jeffmakes/tr23-badge-hw/r2/build/tr23-r2-bom/img/20230305_191125.jpg

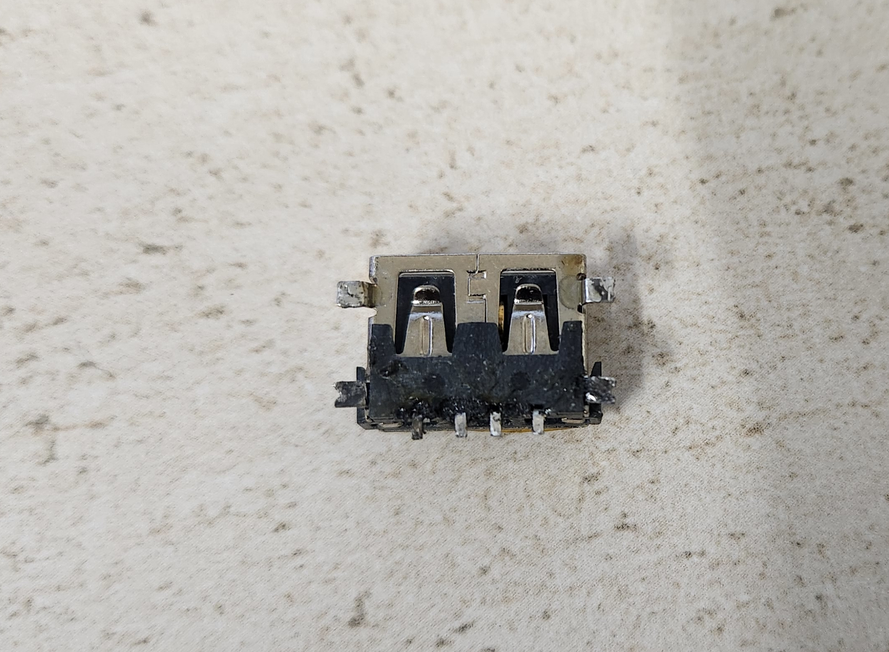
r2/build/tr23-r2-bom/img/20230305_191125.jpg
