jeffmakes/tr23-badge-hw/design/board-graphics/tr23-identity-r1-crop.png

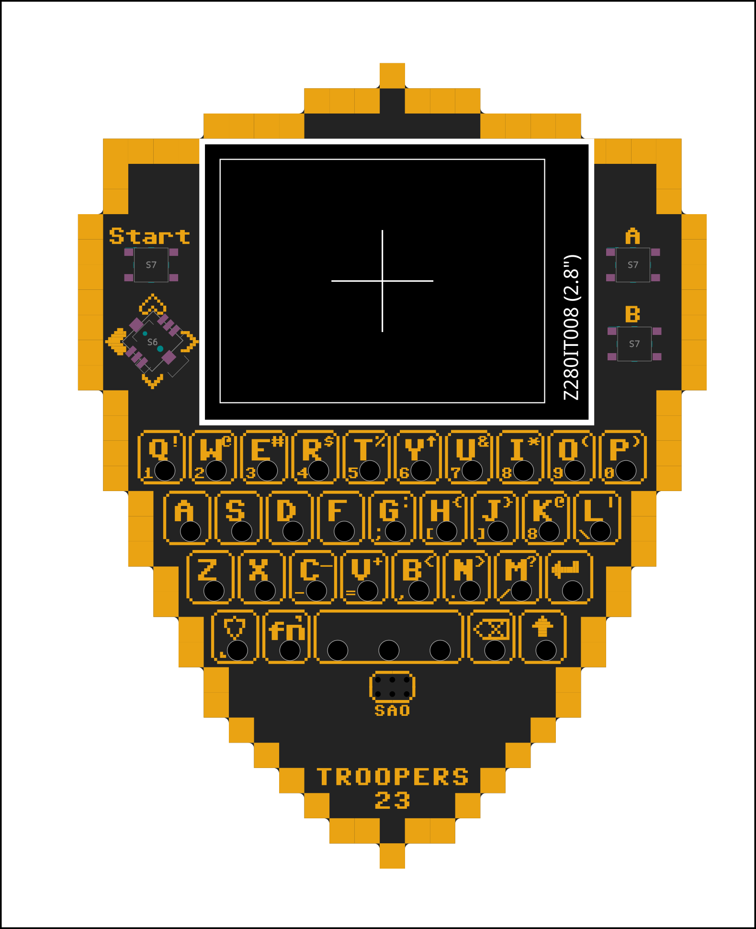
design/board-graphics/tr23-identity-r1-crop.png
