jeffmakes/tr23-badge-hw/design/board-graphics/tr23-identity-r1.png

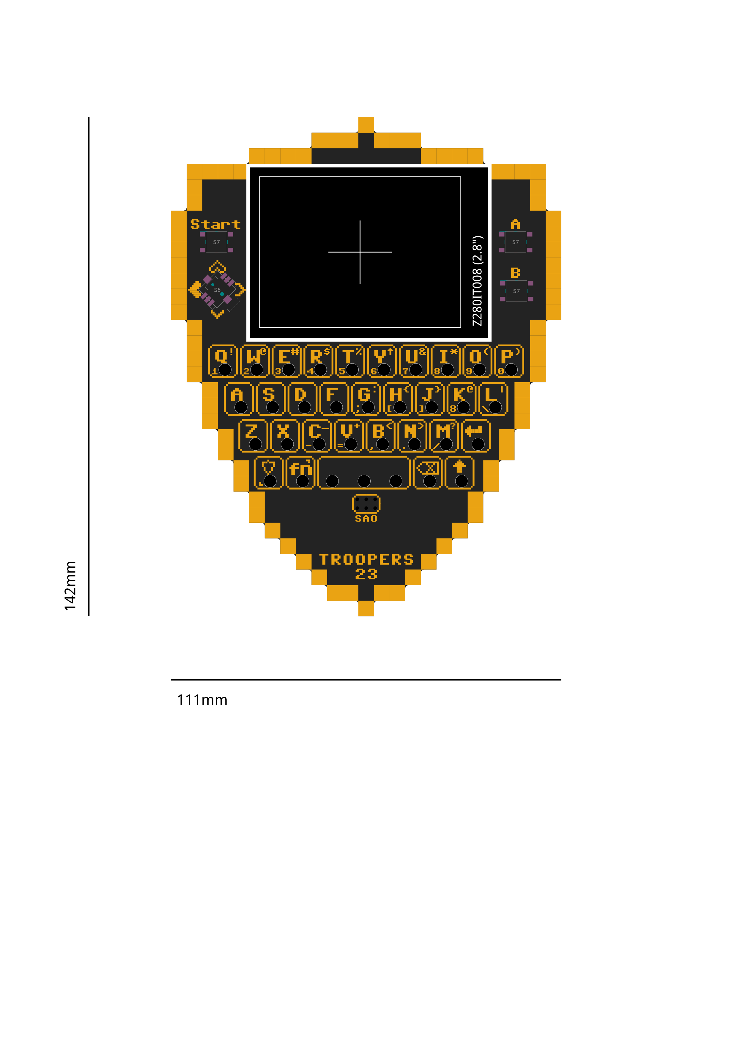
design/board-graphics/tr23-identity-r1.png
