jeffmakes/tr23-badge-hw/r2/build/tr23-r2-bom/img/20230108_FUET-FS1511P01-H40_C482343_back.jpg

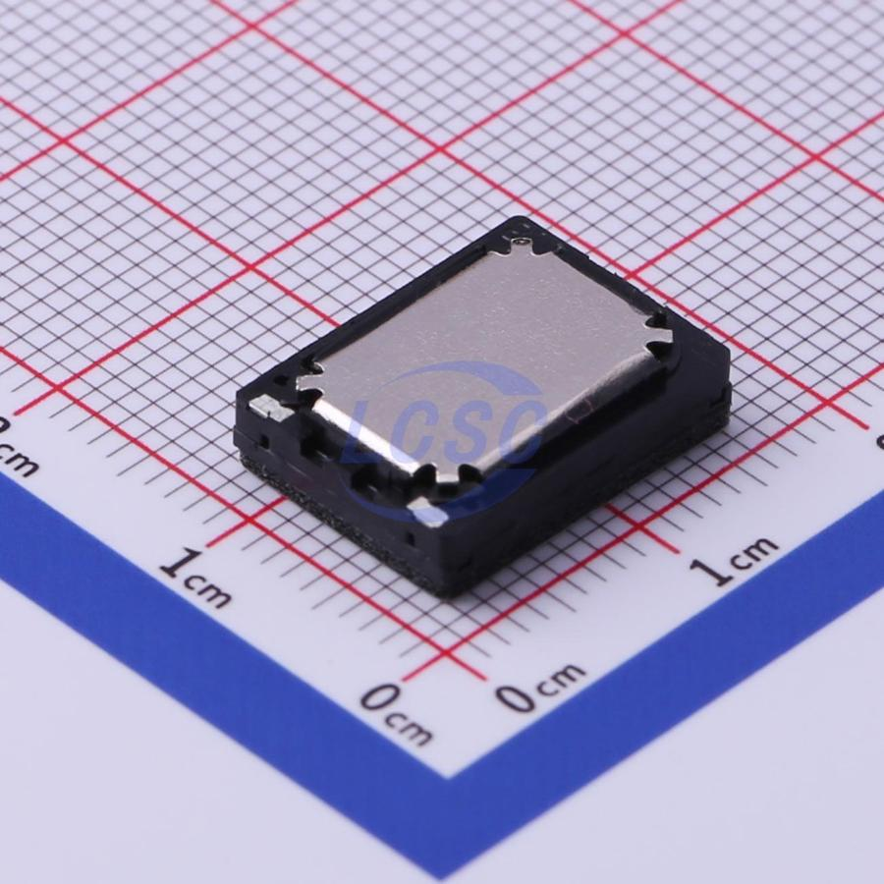
r2/build/tr23-r2-bom/img/20230108_FUET-FS1511P01-H40_C482343_back.jpg
