jeffmakes/tr23-badge-hw/r2/build/tr23-r2-bom/img/colour-switches.png

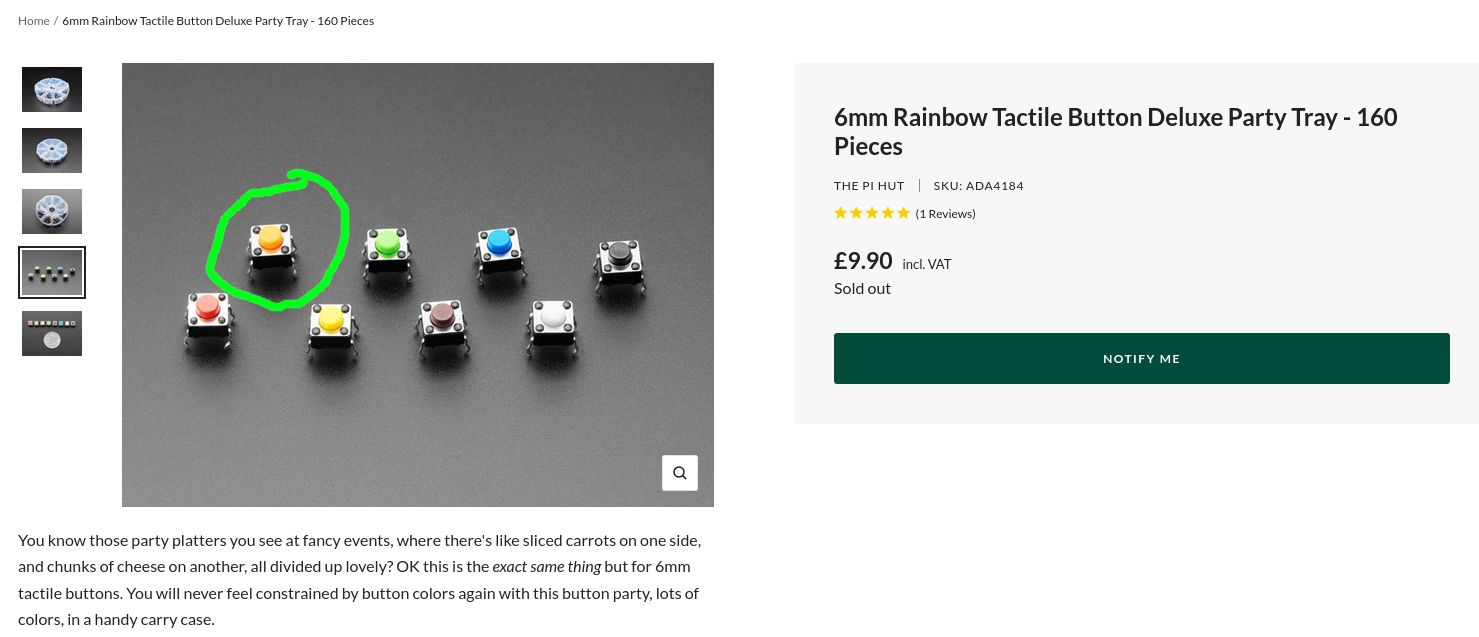
r2/build/tr23-r2-bom/img/colour-switches.png
