jeffmakes/tr23-badge-hw/r2/build/tr23-r2-bom/img/rev-mount-sw-datasheet1.png

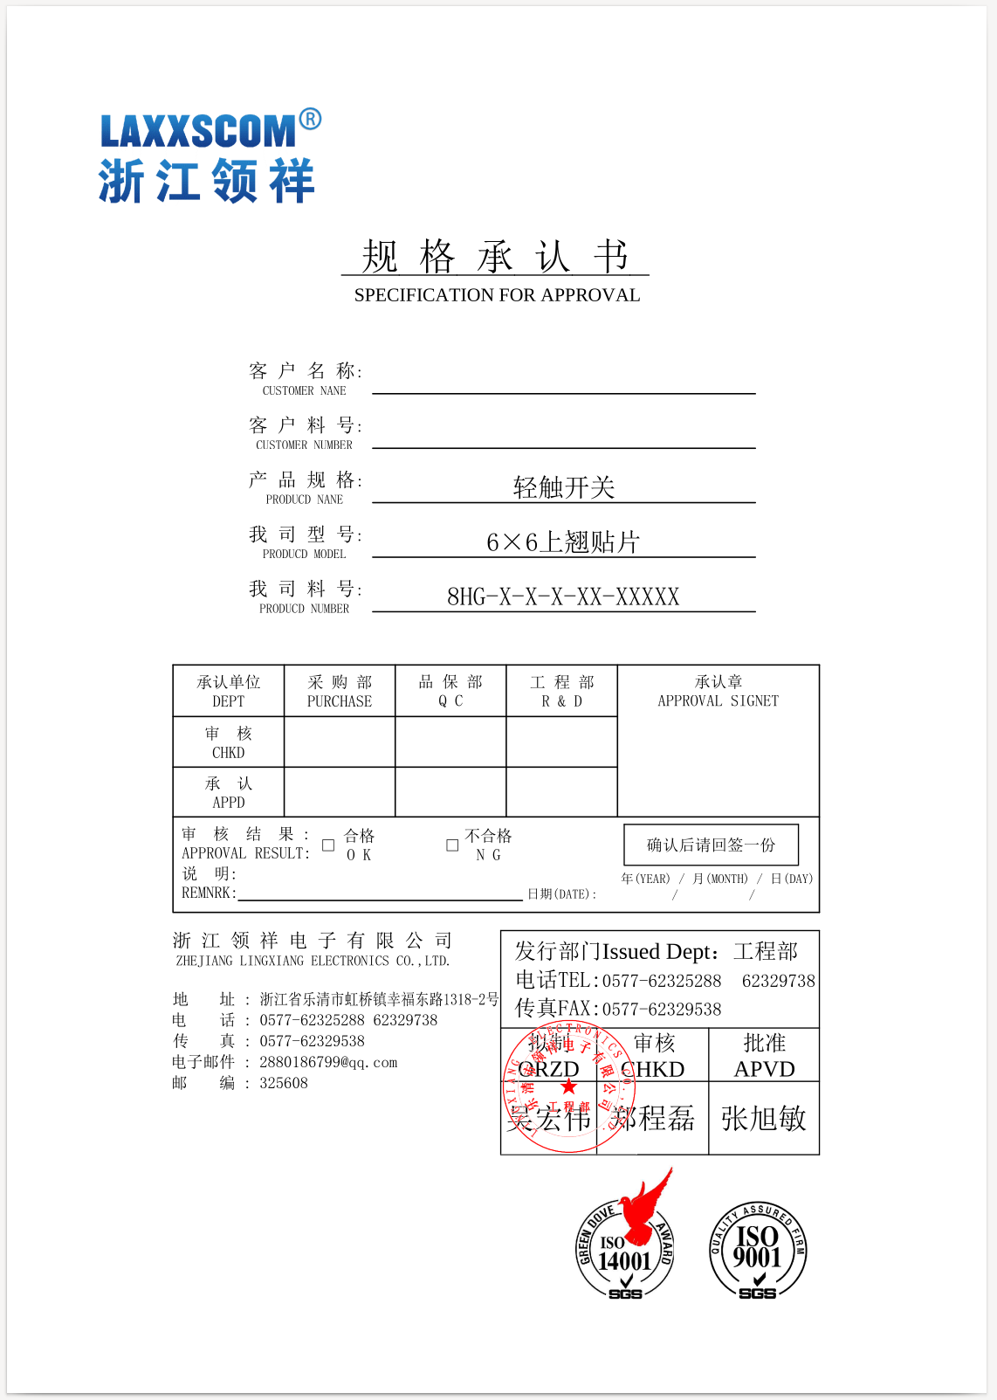
r2/build/tr23-r2-bom/img/rev-mount-sw-datasheet1.png
