jeffmakes/tr23-badge-hw/r2/build/tr23-r2-bom/img/reverse-mount-switch.jpg

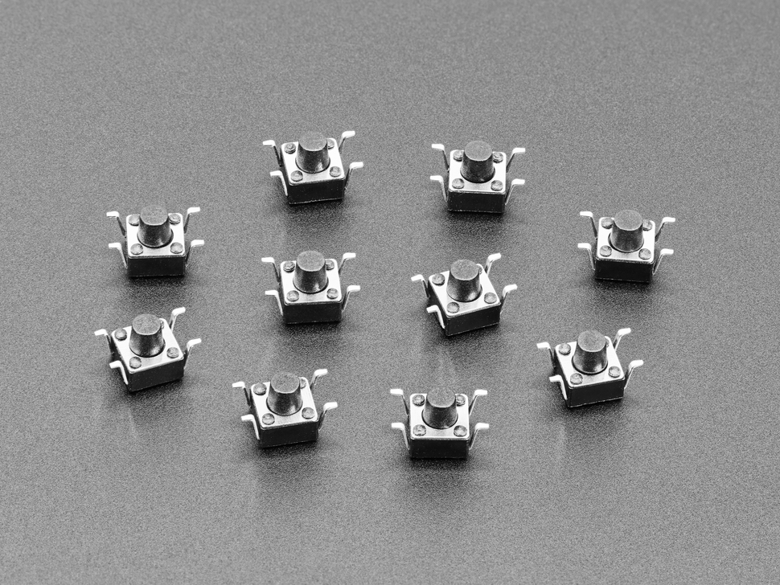
r2/build/tr23-r2-bom/img/reverse-mount-switch.jpg
