jeffmakes/tr23-badge-hw/r2/build/README.txt

PCB spec:

4-layer
Thickness: 1.2mm
Material: FR4

Silkscreen: Orange LPI top and bottom. 
Resist: Black matte finish top and bottom
Vias tented
Plating - Any

Gerber stack-up:
F.Cu 35um
In1.Cu 17um
In2.Cu 17um
B.Cu 35um
