jeffmakes/tr23-badge-hw/tr23-outline-test-r1/build/README.txt

Stackup:
Total thickness 1.6mm

Outline profile: routed all around. Max cutter diameter 2mm. Smaller preferred if reasonable.

Silk - white LPI - front side only
Resist - black (matte preferred if available as standard). Please also quote for ordinary green.
Plating: any
No PTH's in design.
