jeffmakes/tr23-badge-hw/r2/test/test.ods

Test | Status | Notes
Display | OK
Joystick, buttons | OK
Audio, incl power amp, uSD | OK
Charging | OK
Charging from type-C to type-C cable | OK
Run from battery | OK
Haptic | OK
LED’s | OK | Replaced with LTST-E683CEGBK, which is LiteON’s version of WS2812-3535
Touch; I2C ping will suffice | OK | Still need bootloader client, and test with coverlay
Radio; SPI ping will suffice | OK
Touch surface | OK
