jeffmakes/tr23-badge-hw/tr23-outline-test-r1/build/tr23-outline-test-r1.png

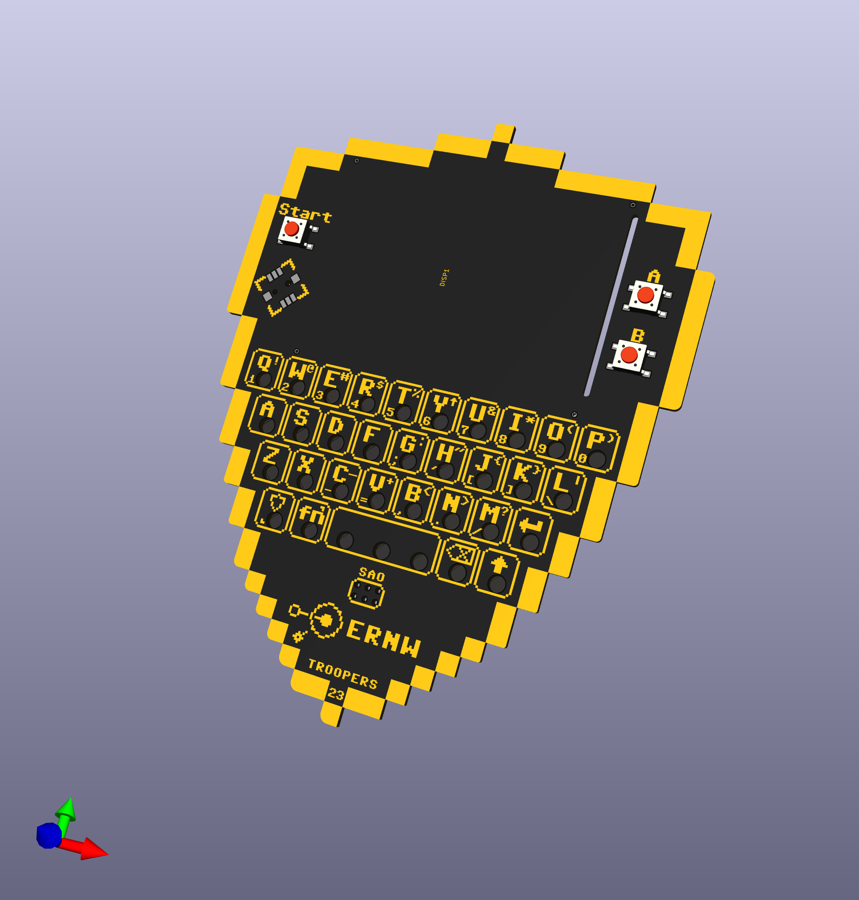
tr23-outline-test-r1/build/tr23-outline-test-r1.png
