jeffmakes/tr23-badge-hw/r2/build/tr23-r2-plots/tr23-badge-r2.pdf

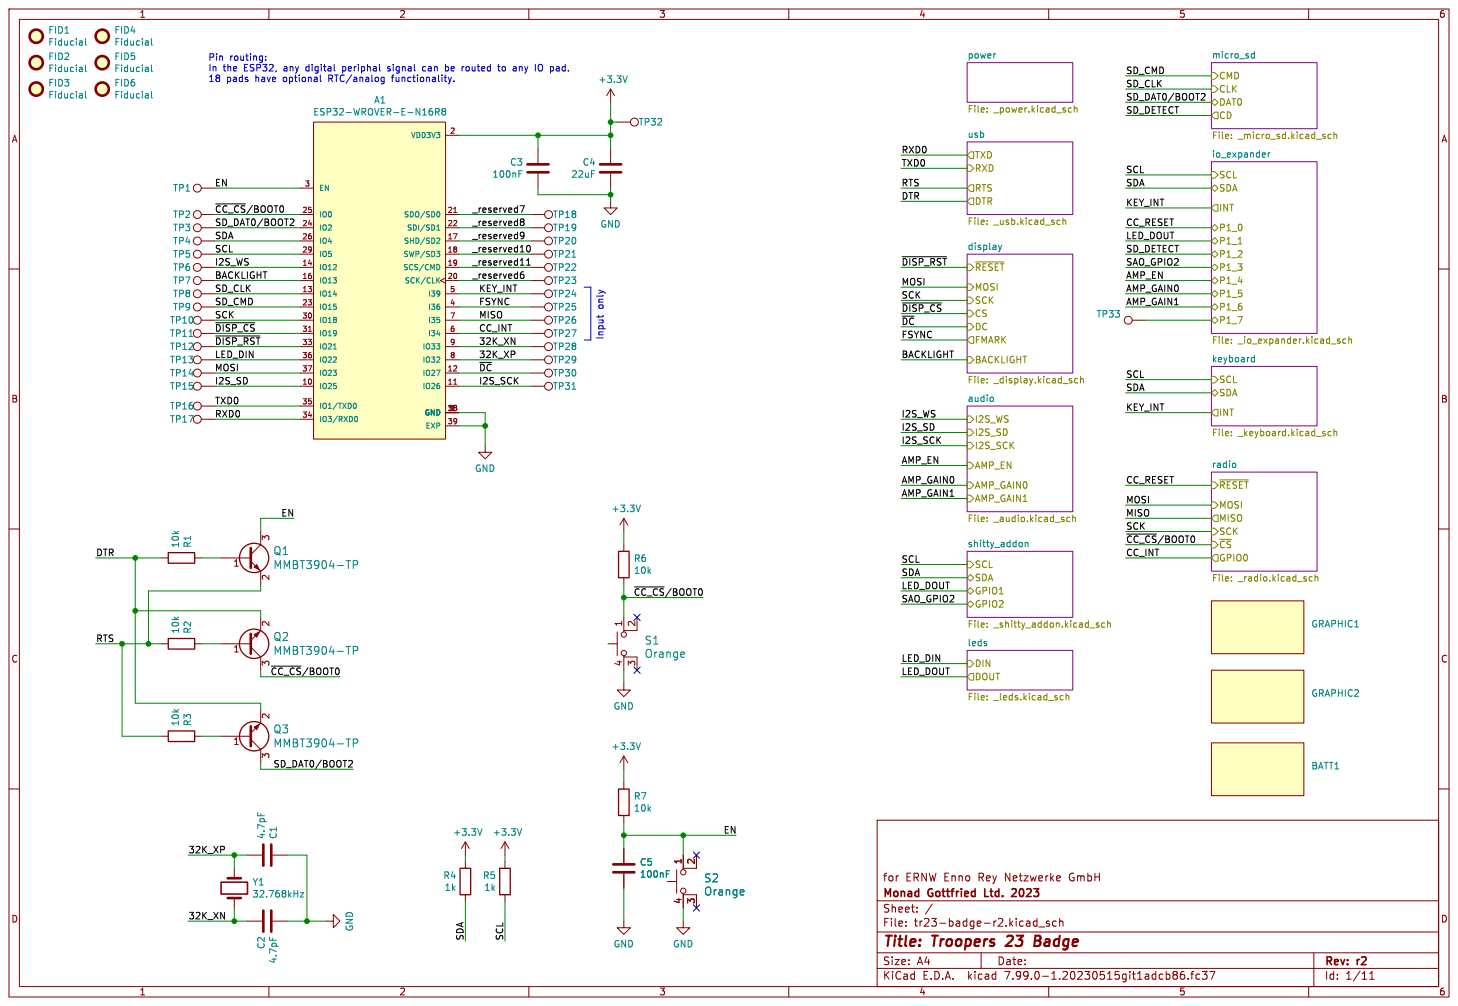
[picture p18: page 1]

power File: _power.kicad_sch RTS RXD

CLK DAT0 CD micro_sd File: _micro_sd.kicad_sch BACKLIGHT CSDC
io_expander File: _io_expander.kicad_sch MOSI MISO
display File: _display.kicad_sch DIN

Id: 1/11 Title: Troopers 23 Badge

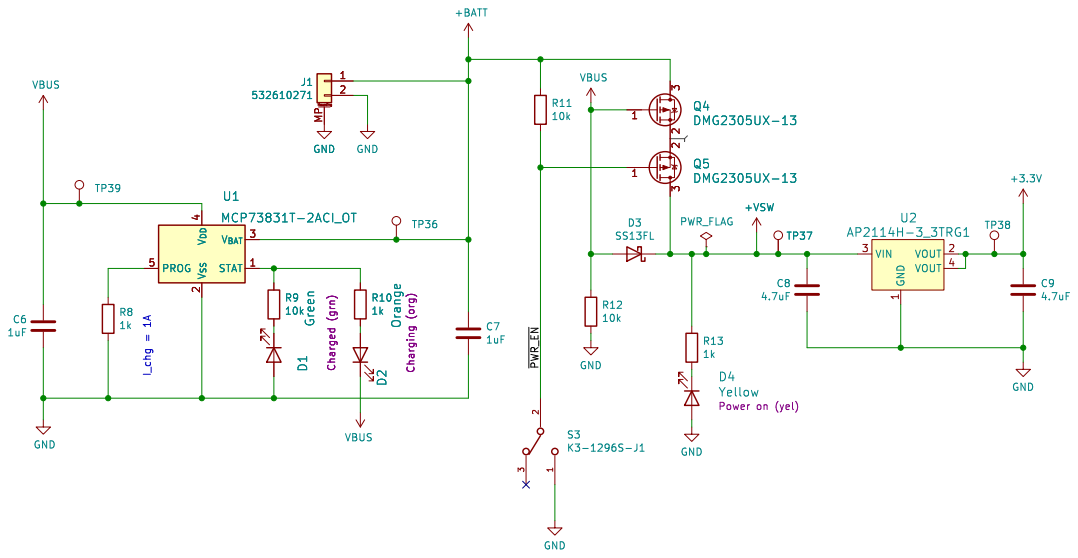
[picture p19: page 2]

Id: 2/11 Title: Troopers 23 Badge

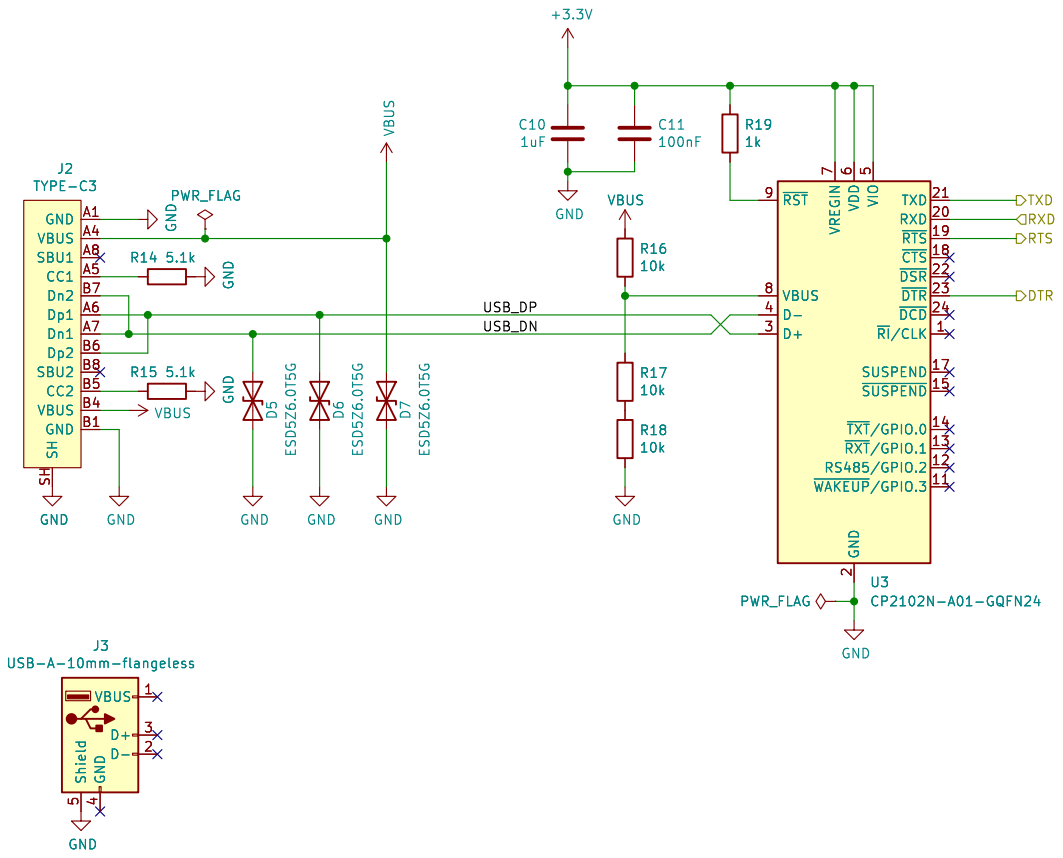
[picture p20: page 3]

7 VBUS 8 ~{RST} 9 U3 PWR_FLAG CP2102N-A01-GQFN24 GND A1 VBUS A4 CC1 A5 Dp1 A6 Dn1 A7 SBU1 A8 GND B1 VBUS B4 CC2 B5 Dp2 B6 Dn2 B7 SBU2 B8 SH SH J2 TYPE-C3 GND

2 RXD 20 TXD 21 ~{DSR} 22 ~{DTR} 23 ~{DCD} 24 D+ 3 D- 4 VIO

Id: 3/11 Title: Troopers 23 Badge

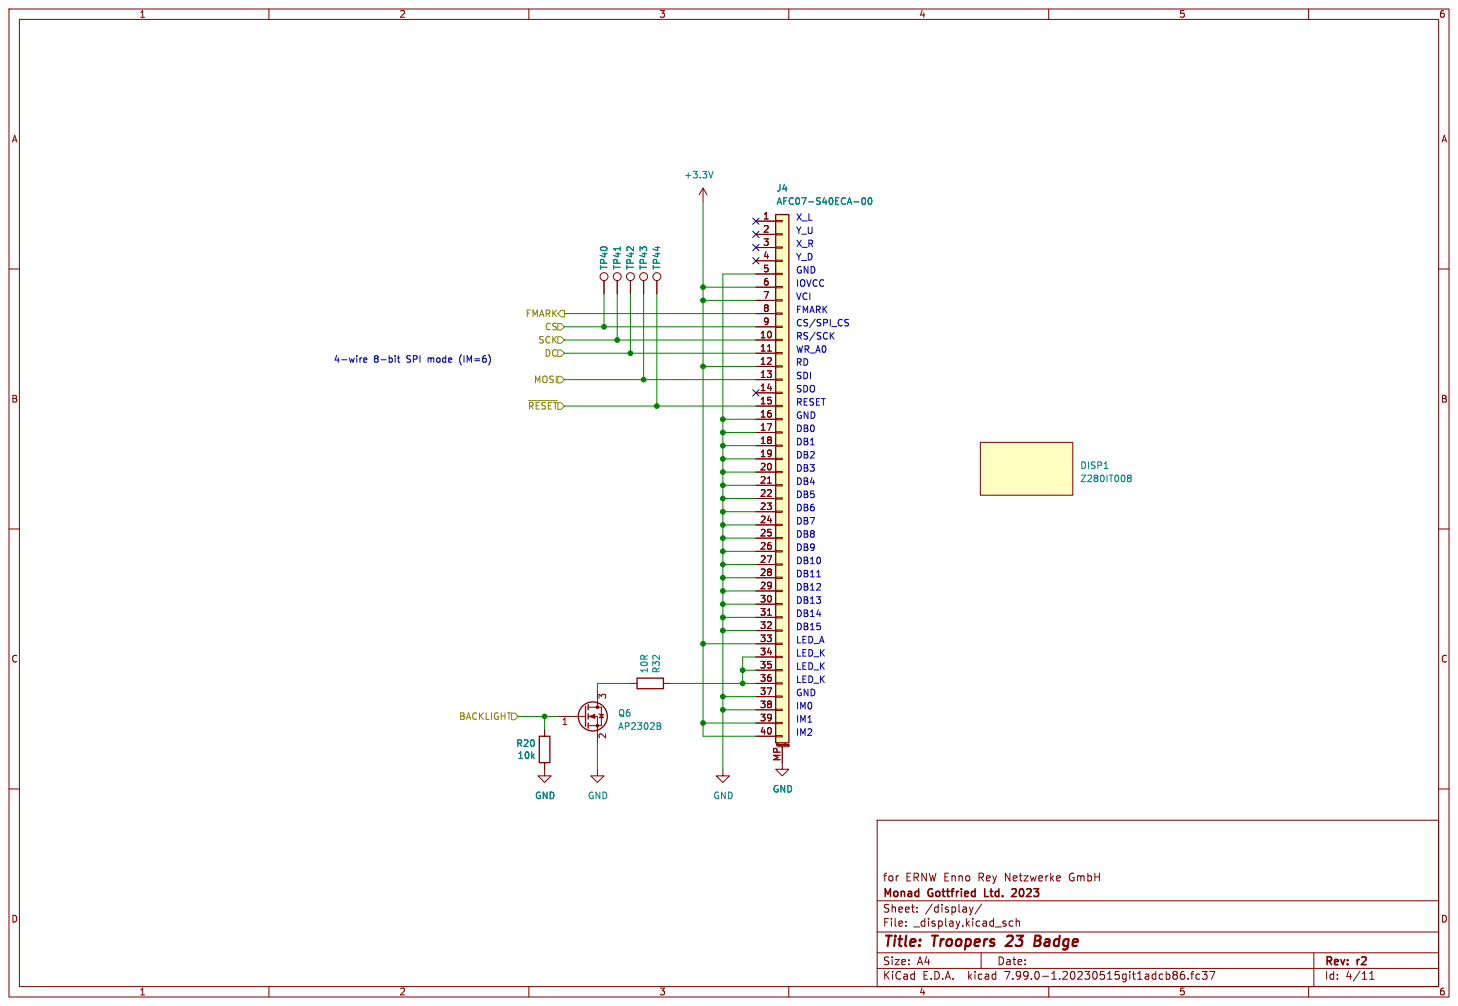
[picture p21: page 4]

394 394 13 13 14 14 15 15 16 16 | Mounting 1
192 192 293 293 10 10 11 11 12 12

Id: 4/11 Title: Troopers 23 Badge

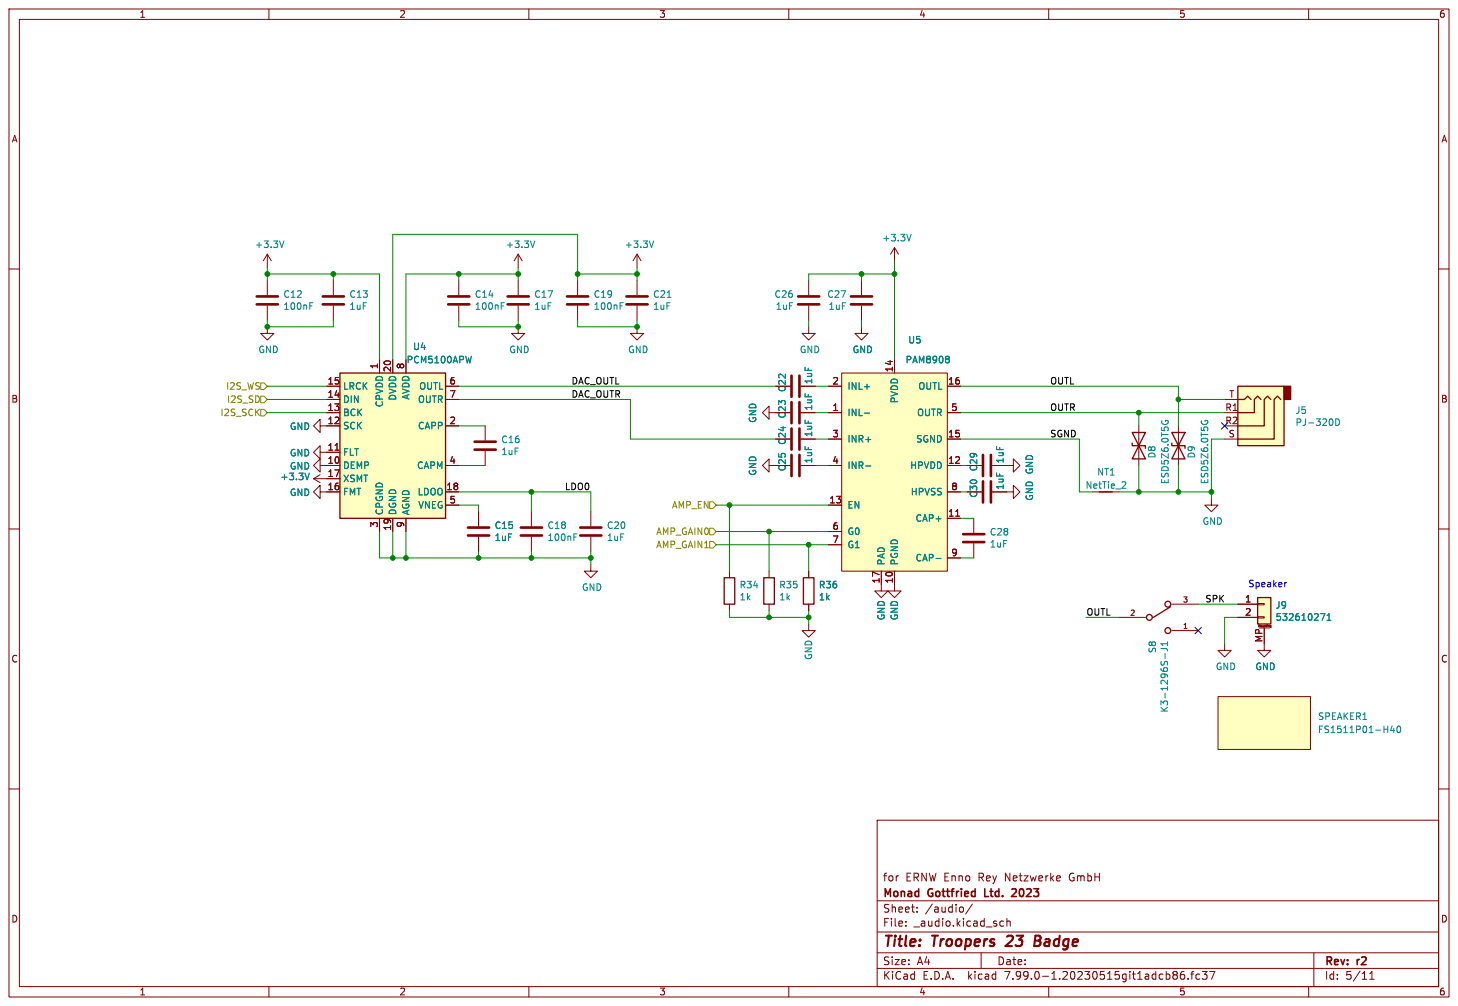
[picture p22: page 5]

1 DEMP 10 FLT 11 SCK 12 BCK 13 DIN 14

3 CAPM 4 VNEG 5 OUTL 6 OUTR AVDD 7

1uF GND GND GND GND

Id: 5/11 Title: Troopers 23 Badge

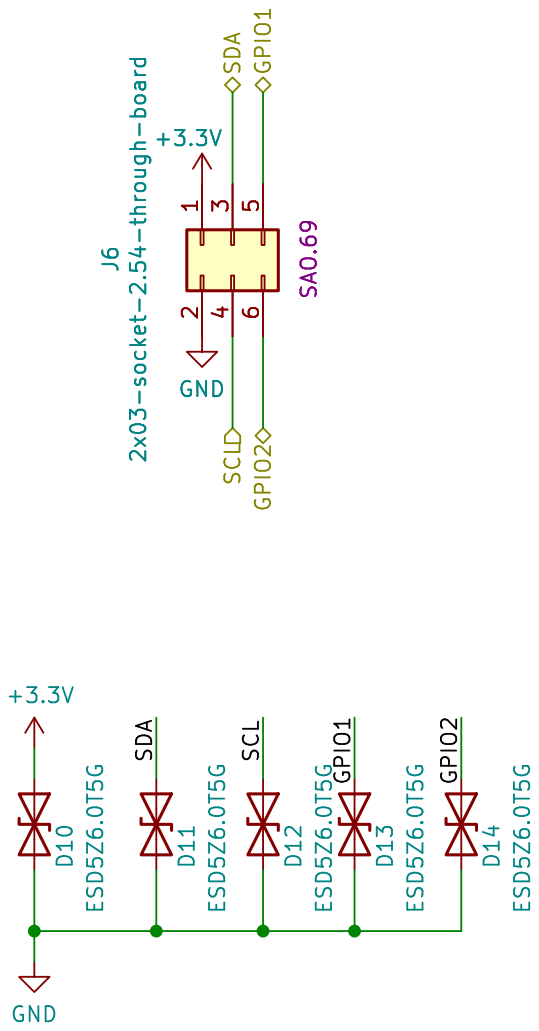
[picture p23: page 6]

Id: 6/11 Title: Troopers 23 Badge

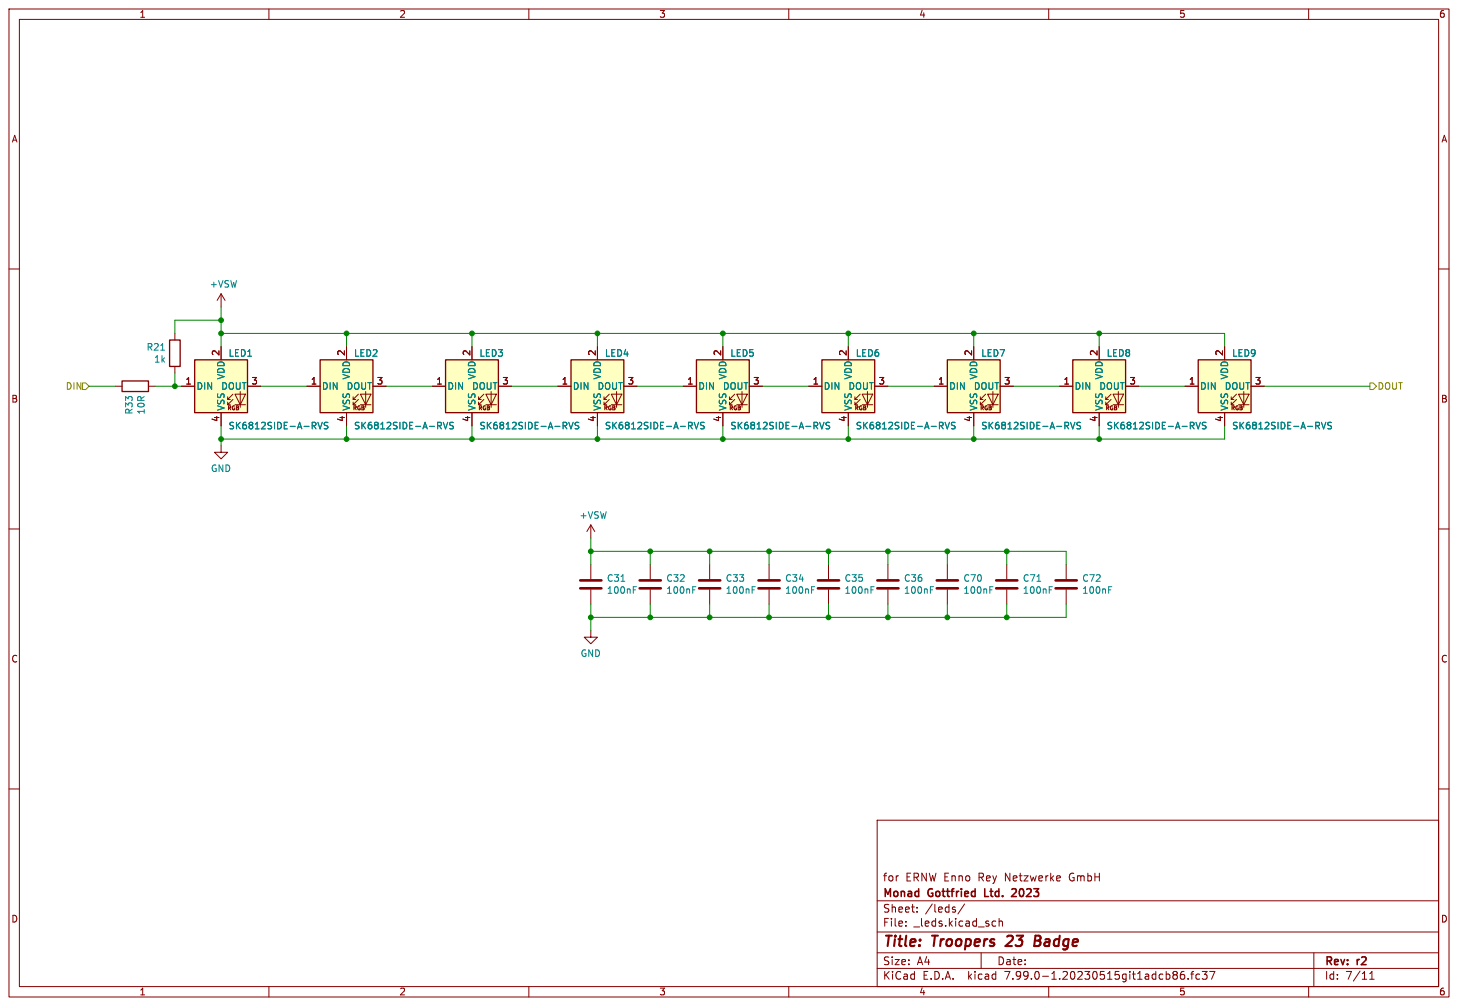
[picture p24: page 7]

Id: 7/11 Title: Troopers 23 Badge

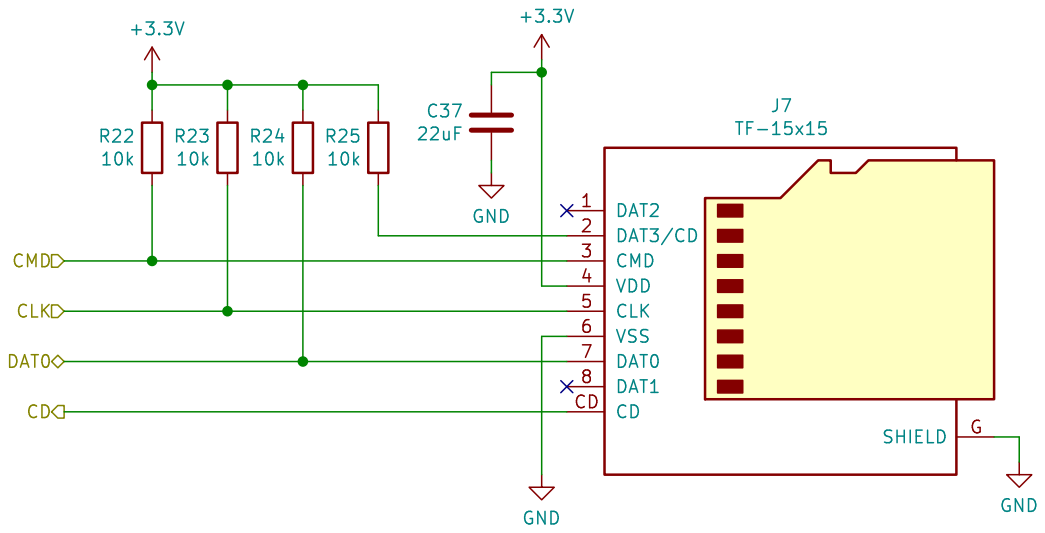
[picture p25: page 8]

Id: 8/11 Title: Troopers 23 Badge

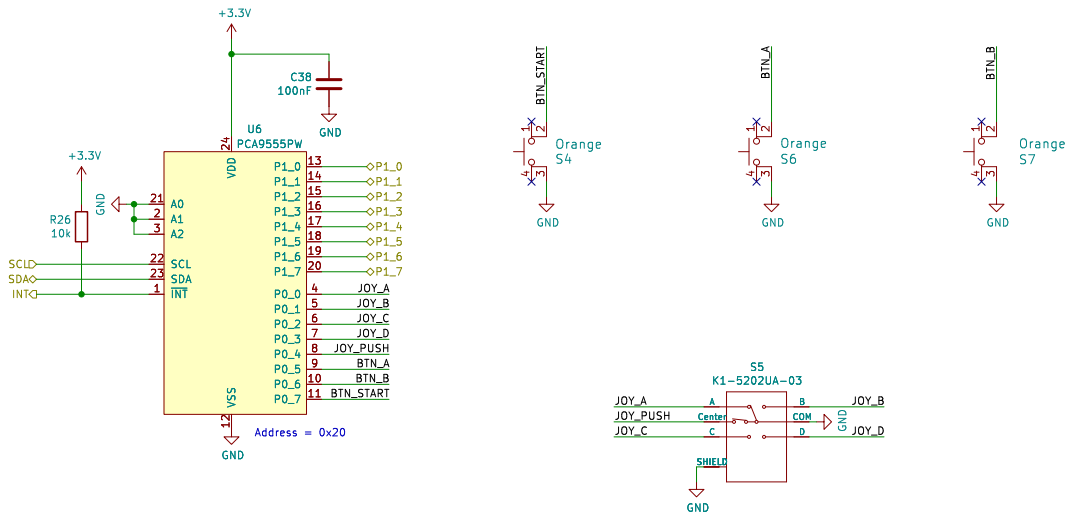
[picture p26: page 9]

Id: 9/11 Title: Troopers 23 Badge

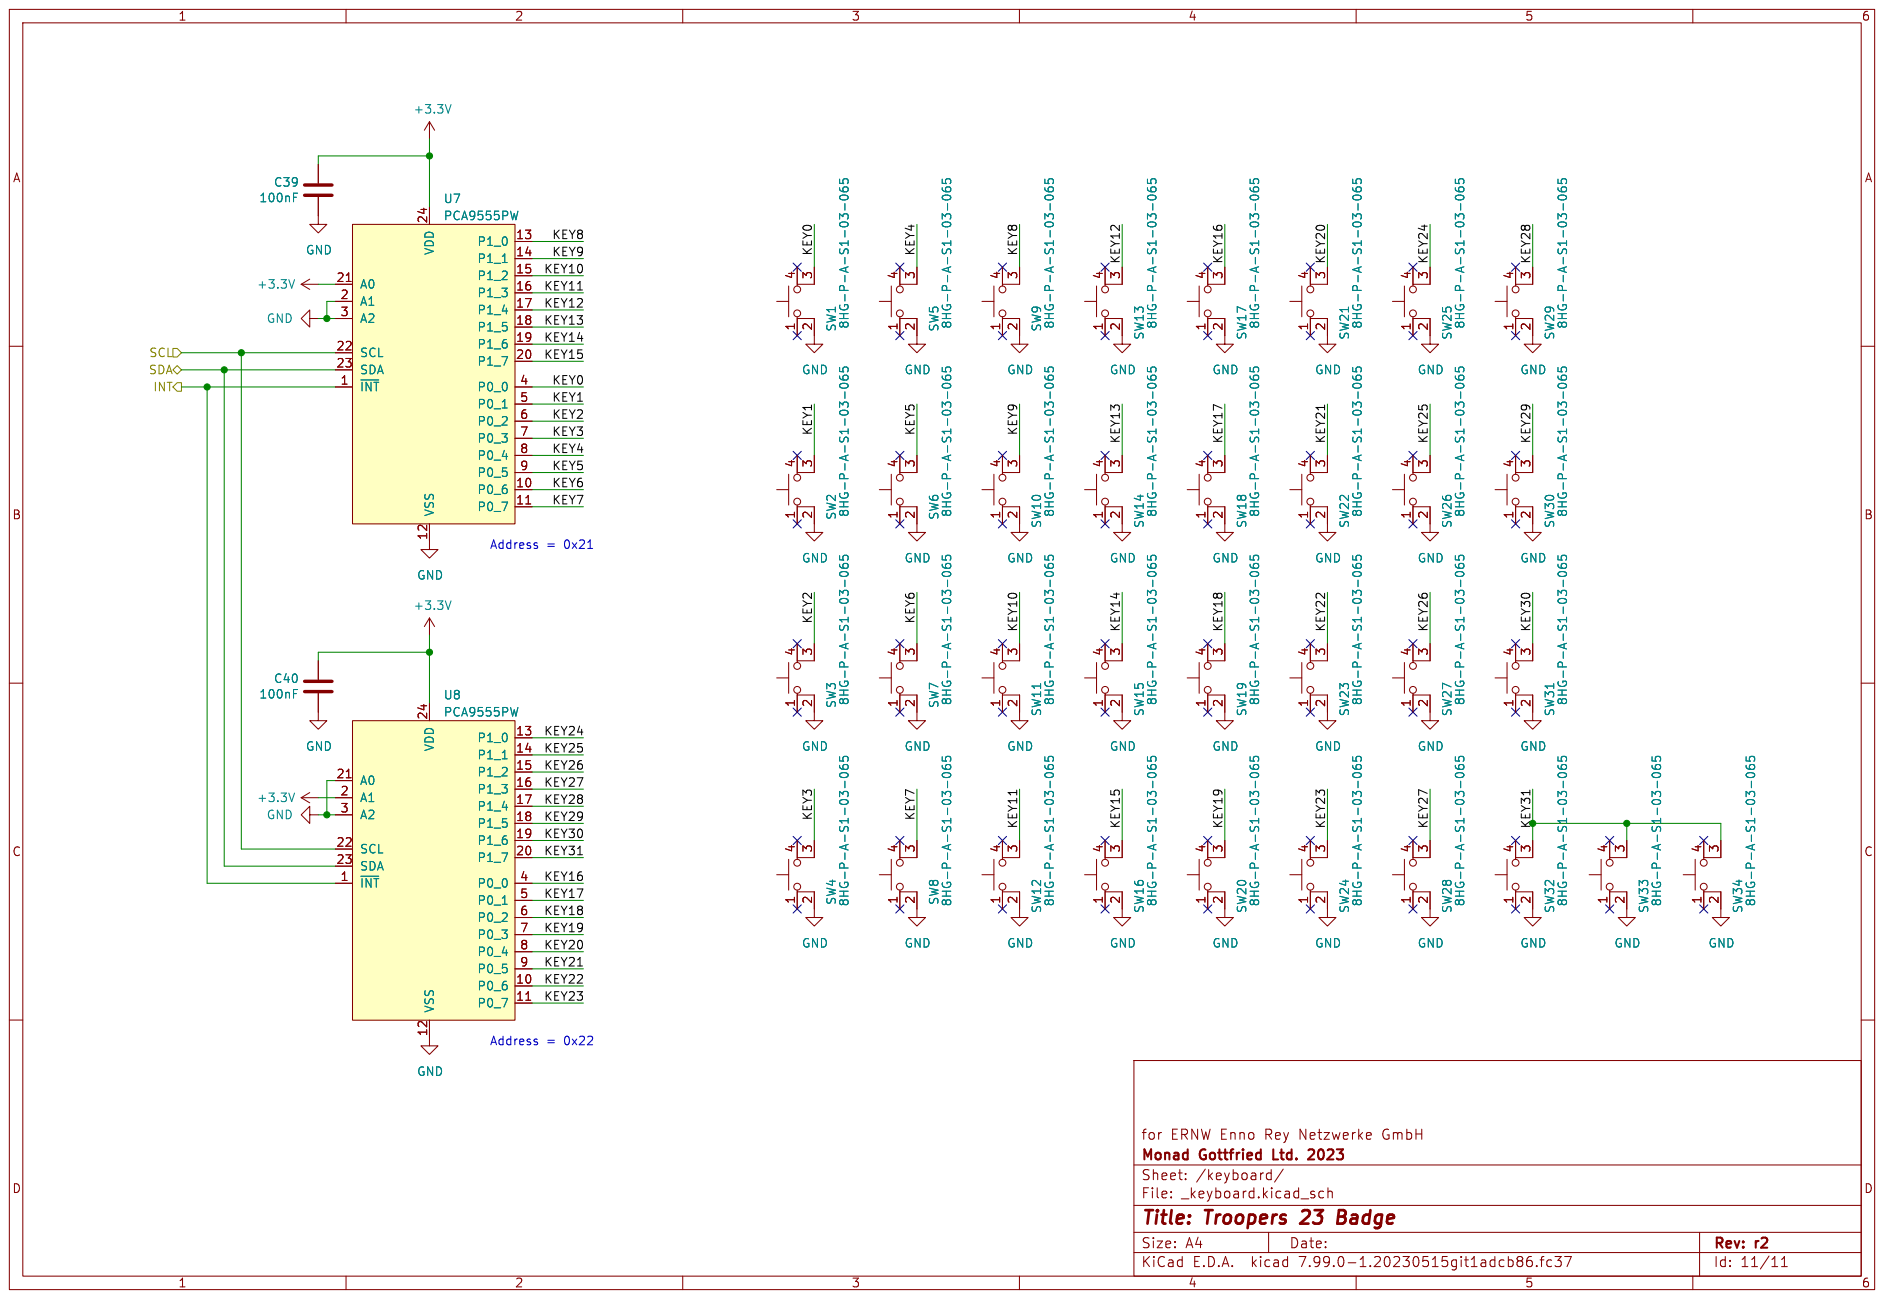
[picture p27: page 10]

Id: 11/11 Title: Troopers 23 Badge

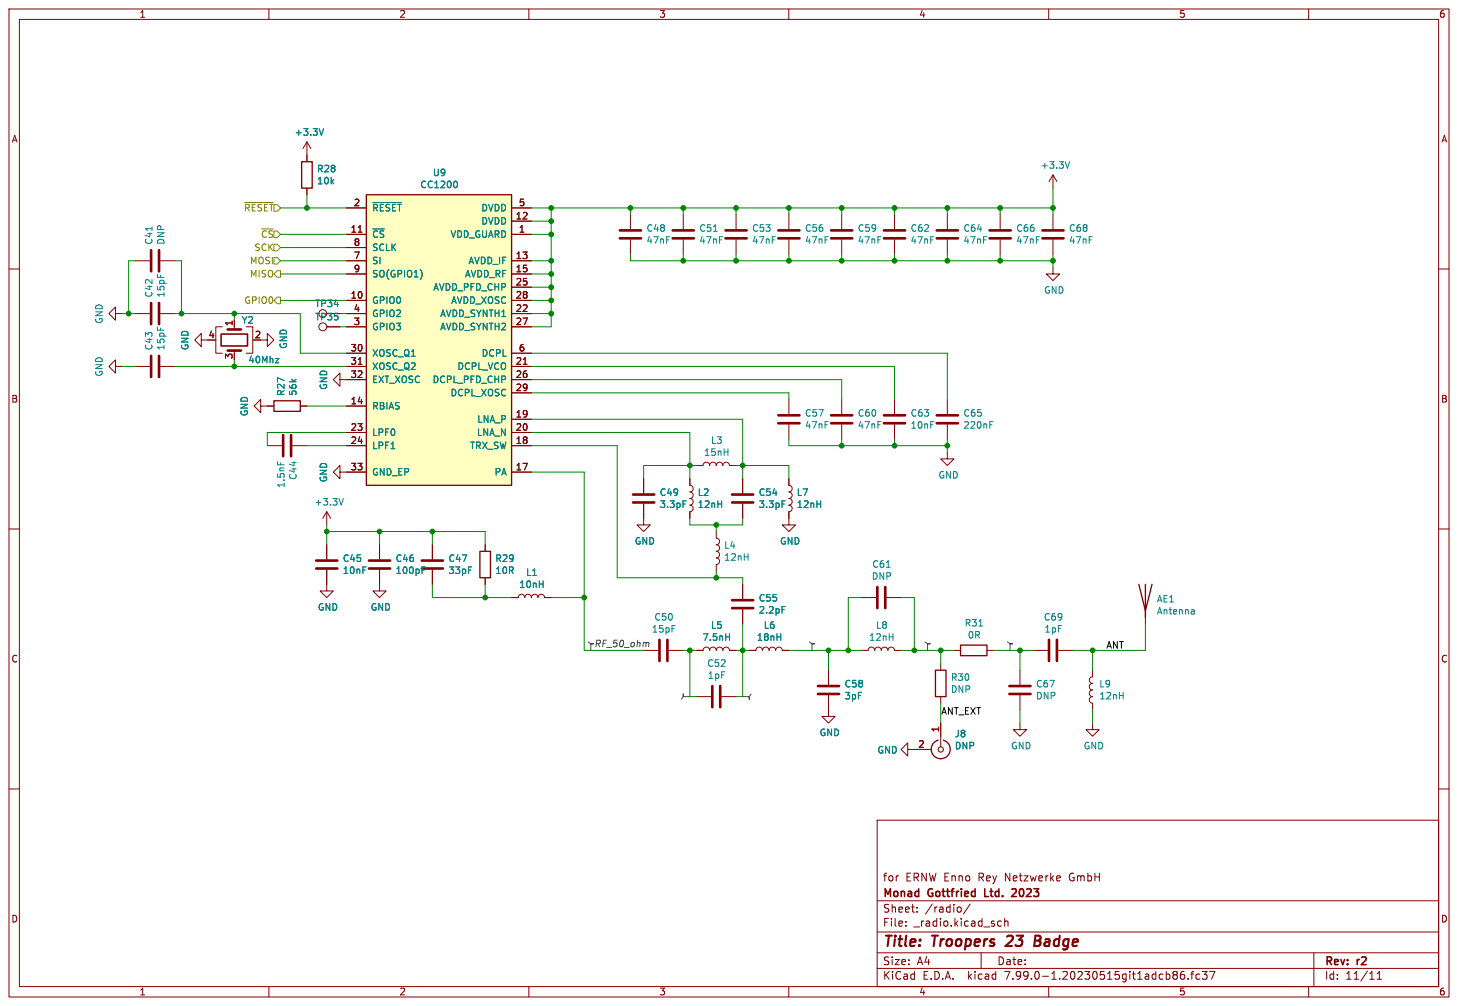
[picture p28: page 11]

Id: 11/11 Title: Troopers 23 Badge
