jeffmakes/tr23-badge-hw/r1/build/tr23-r1-schematic/tr23-badge-r1.pdf

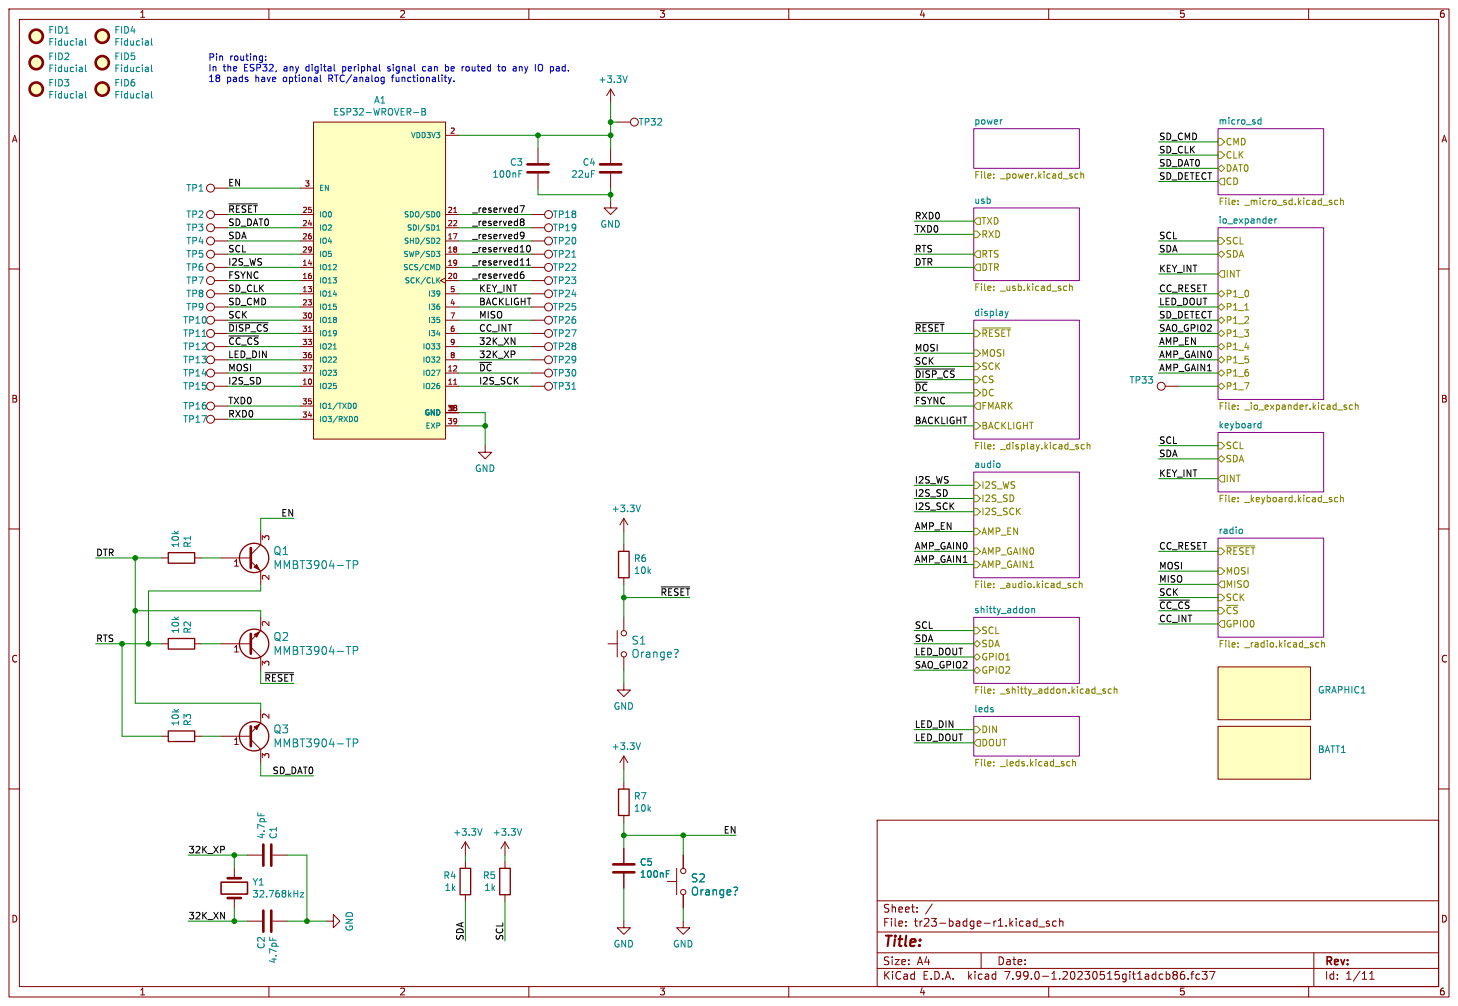
[picture p29: page 1]

CLK DAT0 CD micro_sd File: _micro_sd.kicad_sch DIN

Id: 1/11 Title: File: tr23-badge-r1.kicad_sch Sheet: /

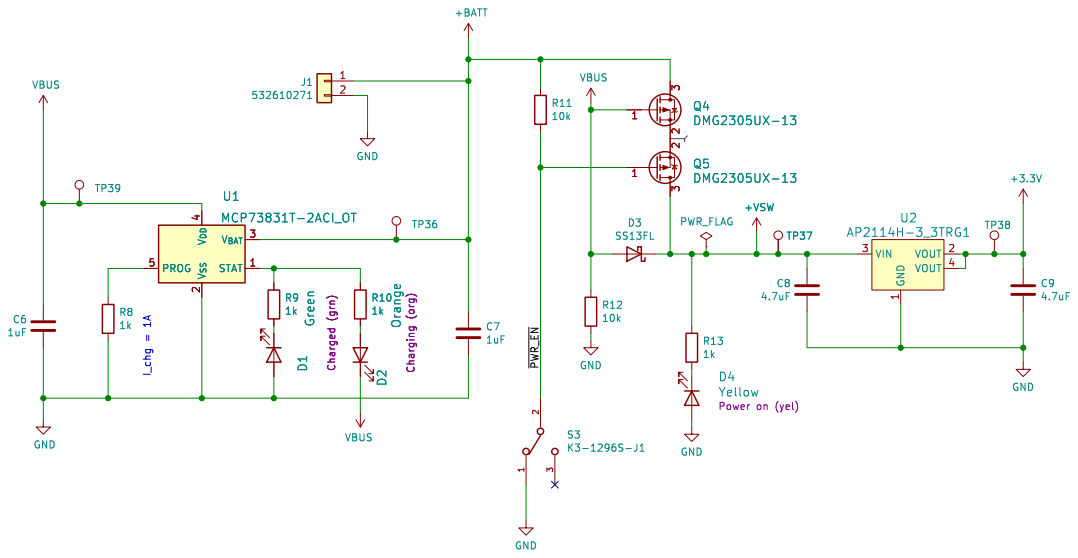
[picture p30: page 2]

Id: 2/11 Title: File: _power.kicad_sch Sheet: /power/ R8
Power on (yel) ~{PWR_EN} I_chg = 1A
1uF GND

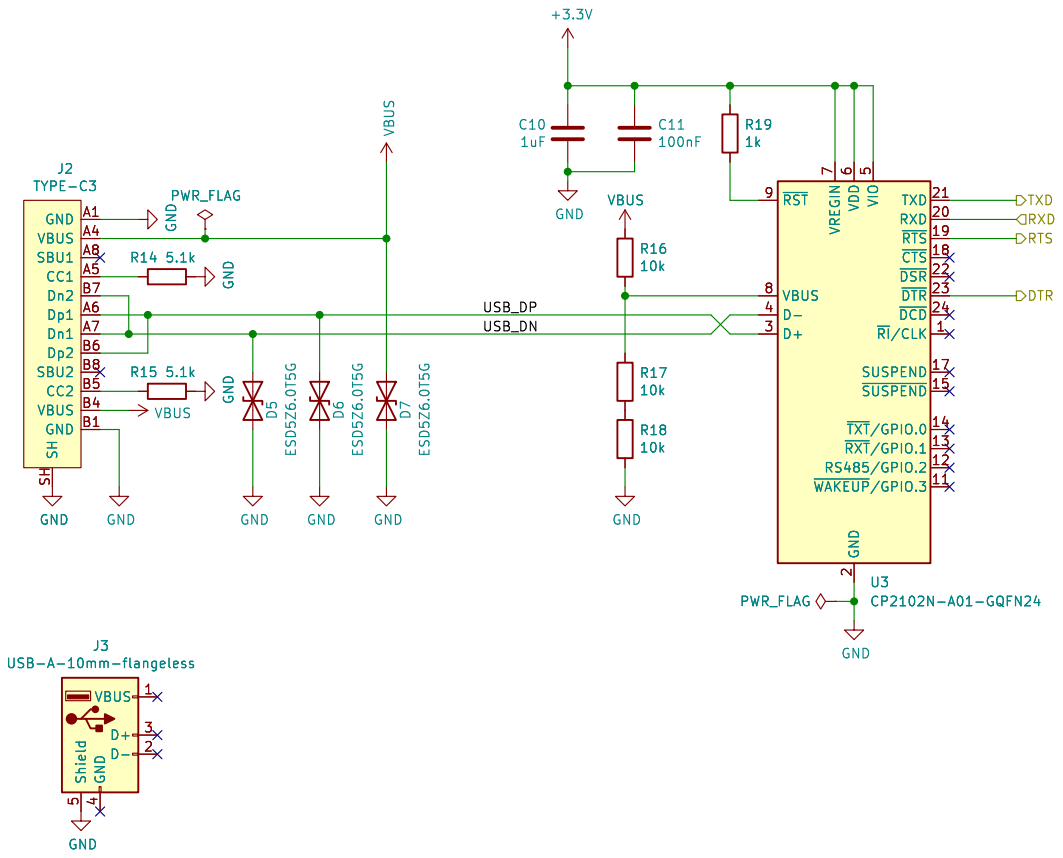
[picture p31: page 3]

7 VBUS 8 ~{RST} 9 U3 PWR_FLAG CP2102N-A01-GQFN24 GND A1 VBUS A4 CC1 A5 Dp1 A6 Dn1 A7 SBU1 A8 GND B1 VBUS B4 CC2 B5 Dp2 B6 Dn2 B7 SBU2 B8 SH SH J2 TYPE-C3 GND GND

2 RXD 20 TXD 21 ~{DSR} 22 ~{DTR} 23 ~{DCD} 24 D+ 3 D- 4 VIO

Id: 3/11 Title: File: _usb.kicad_sch Sheet: /usb/

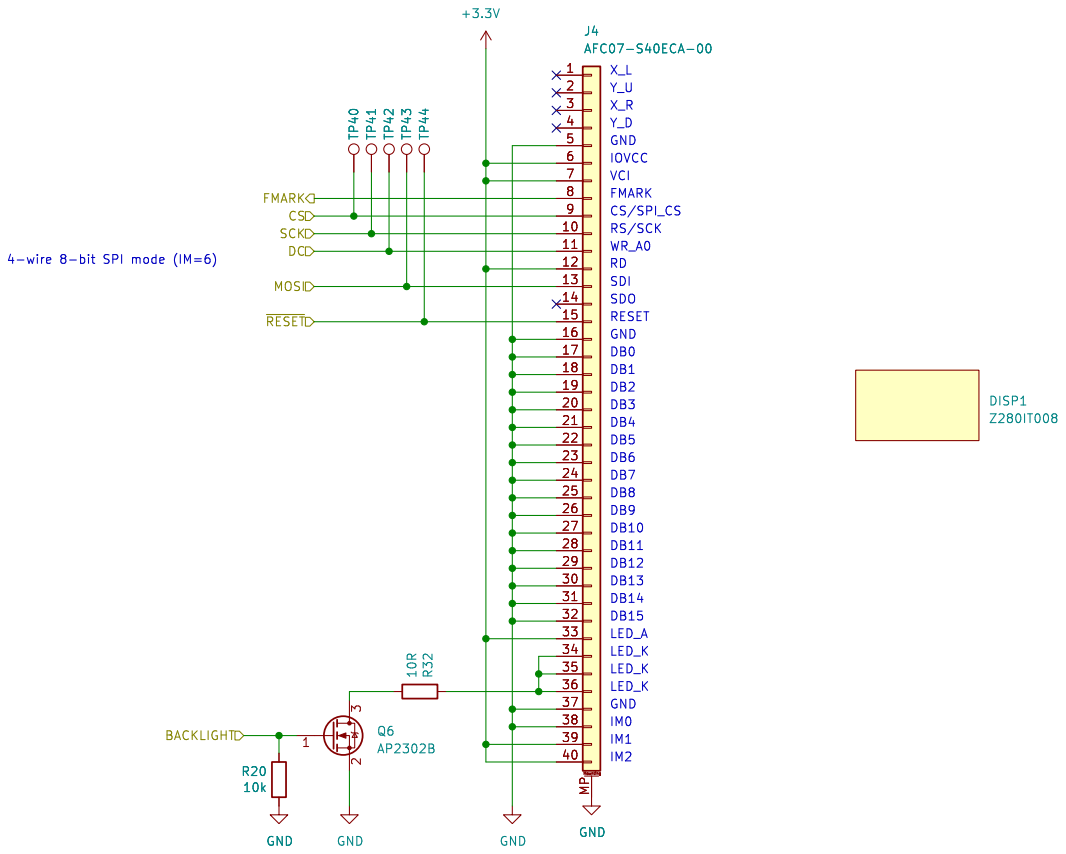
[picture p32: page 4]

394 394 13 13 14 14 15 15 16 16 | Mounting 1
192 192 293 293 10 10 11 11 12 12

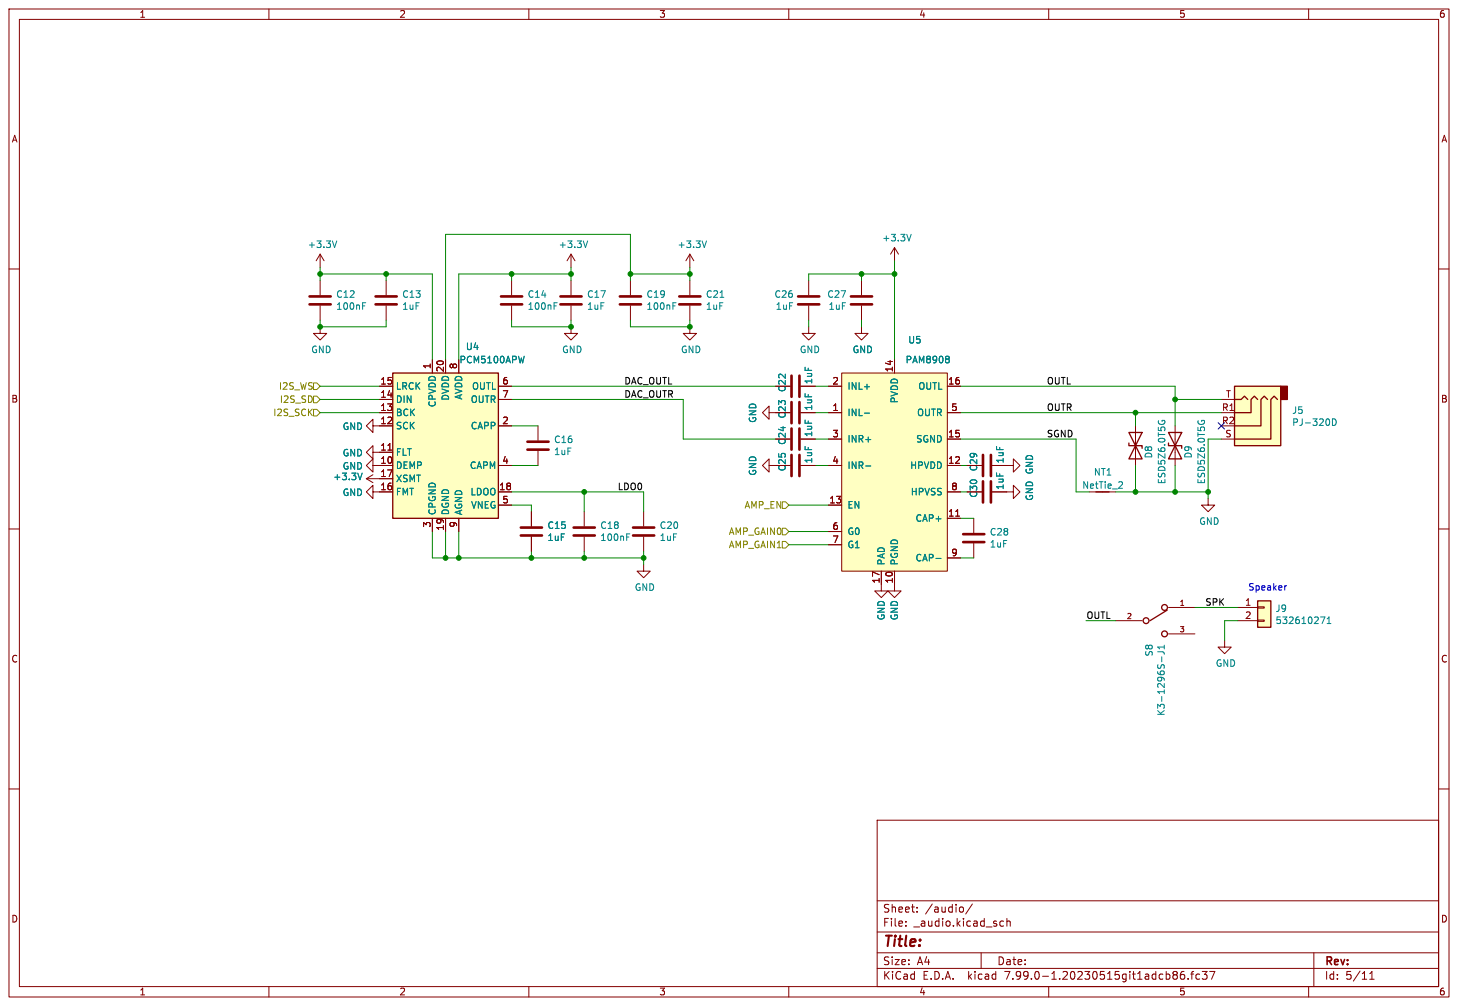
[picture p33: page 5]

1 DEMP 10 FLT 11 SCK 12 BCK 13 DIN 14

3 CAPM 4 VNEG 5 OUTL 6 OUTR AVDD 7

Id: 5/11 Title: File: _audio.kicad_sch Sheet: /audio/


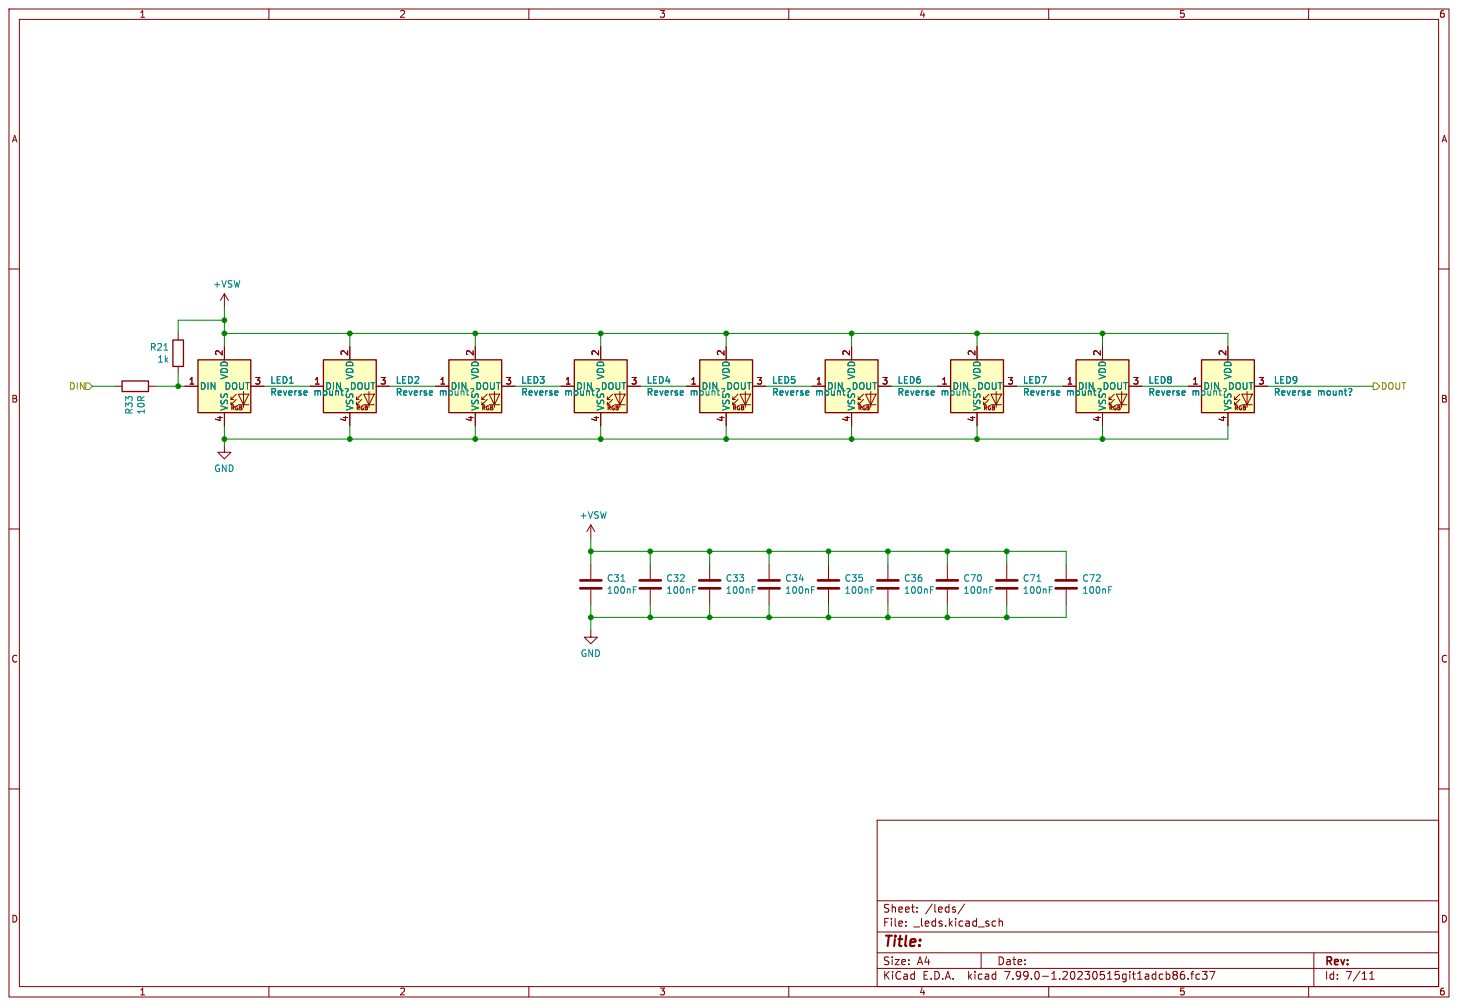
[picture p34: page 7]


Id: 8/11 Title: File: _micro_sd.kicad_sch Sheet: /micro_sd/ GND

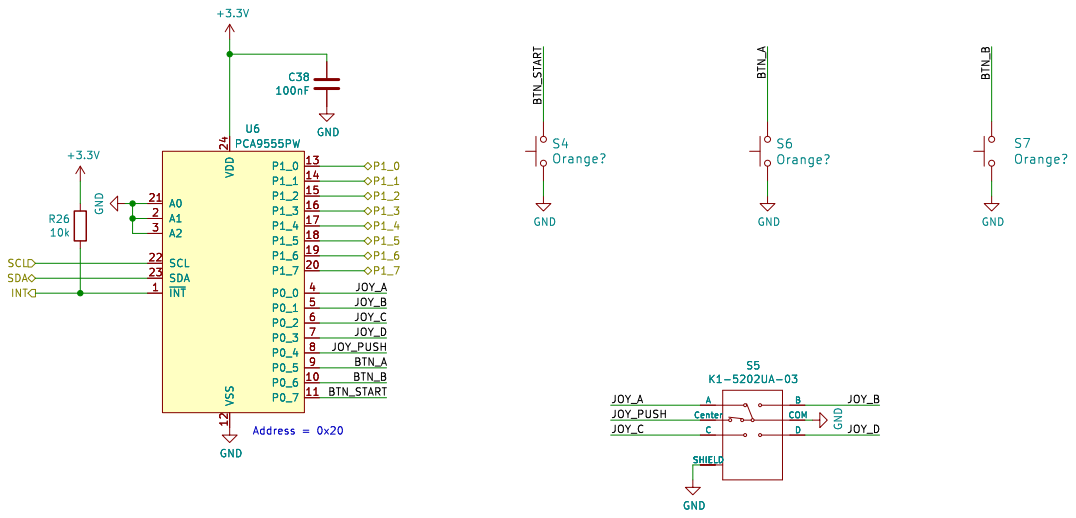
[picture p35: page 9]

Id: 9/11 Title: File: _io_expander.kicad_sch Sheet: /io_expander/

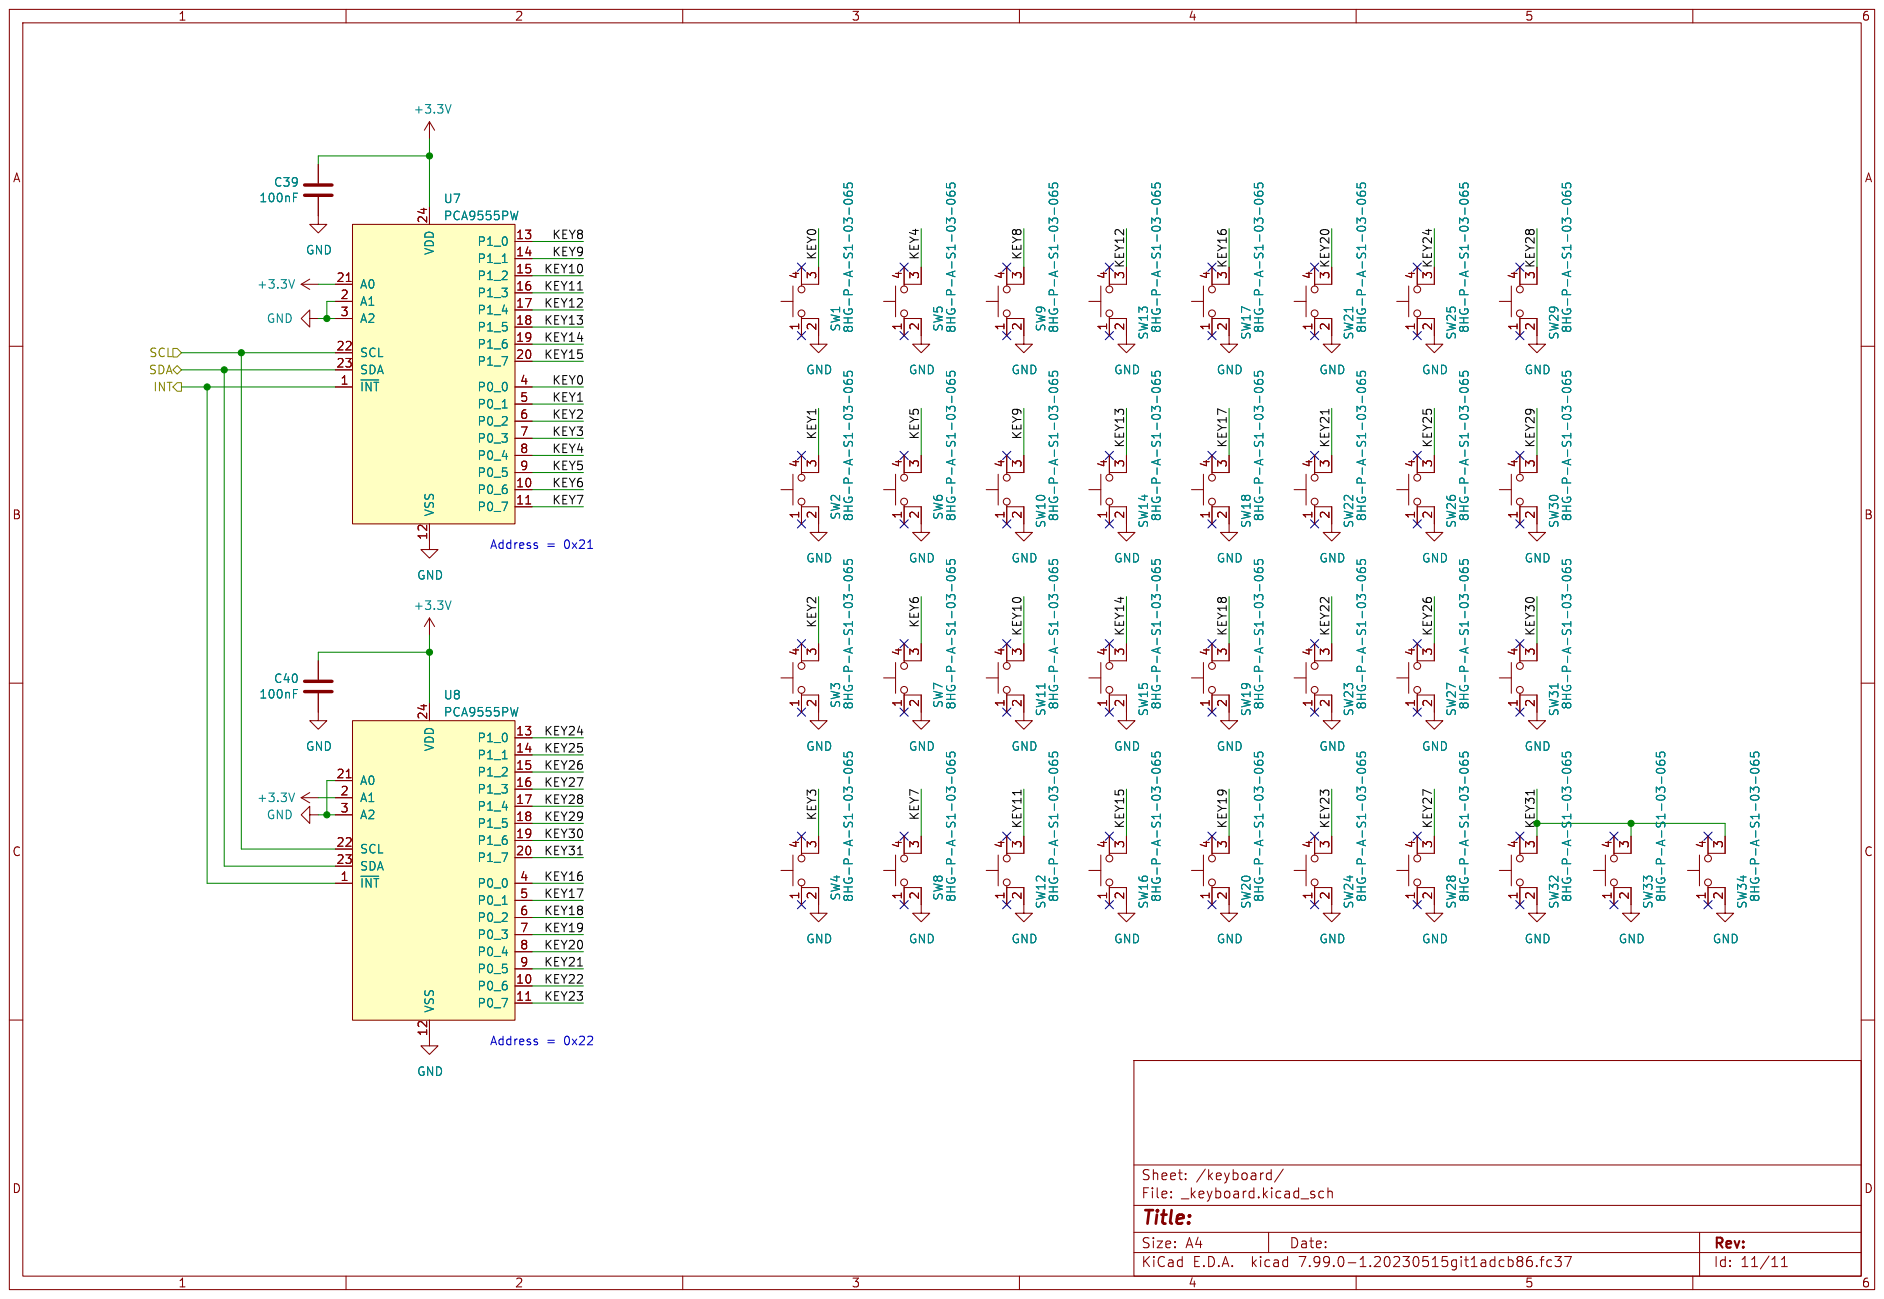
[picture p36: page 10]

Id: 11/11 Title: File: _keyboard.kicad_sch Sheet: /keyboard/ GND

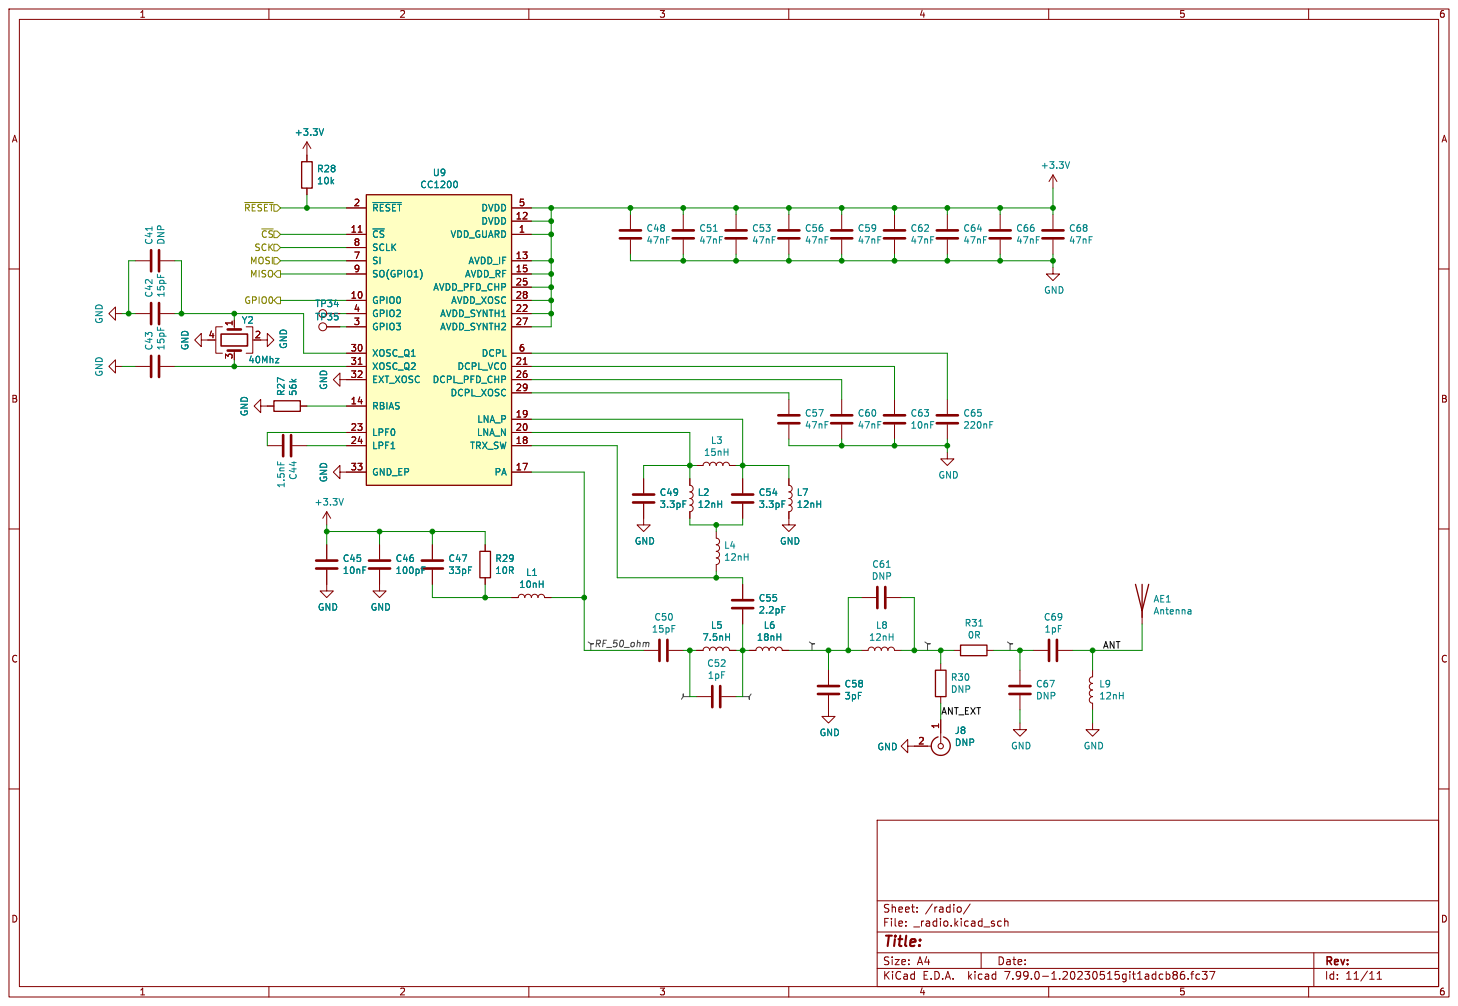
[picture p37: page 11]

2 GND
Id: 11/11 Title: File: _radio.kicad_sch Sheet: /radio/ GND
