jeffmakes/tr23-badge-hw/r2/build/tr23-r2-assembly/tr23-badge-r2-F_Fab.pdf

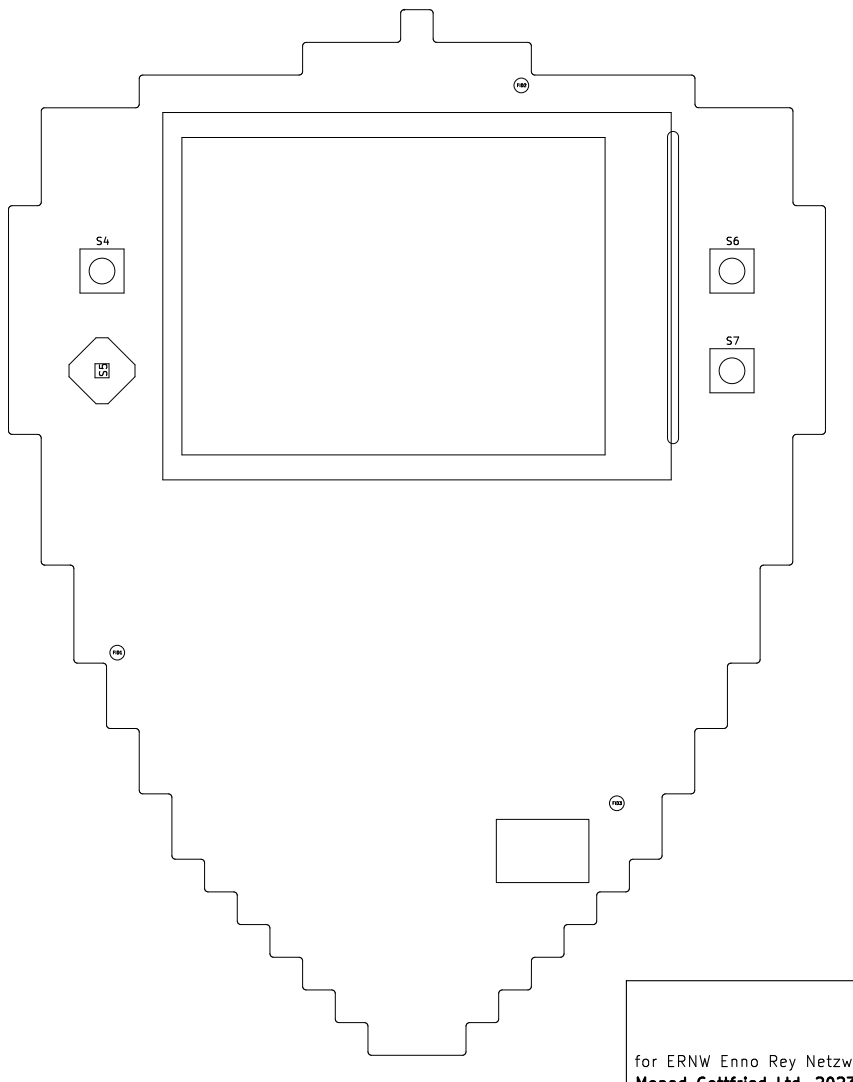
[picture p39: page 1]

Id: 1/1 Title: Troopers 23 Badge
