jeffmakes/tr23-badge-hw/r1/build/tr23-r1-assembly/tr23-badge-r1-bottom.pdf

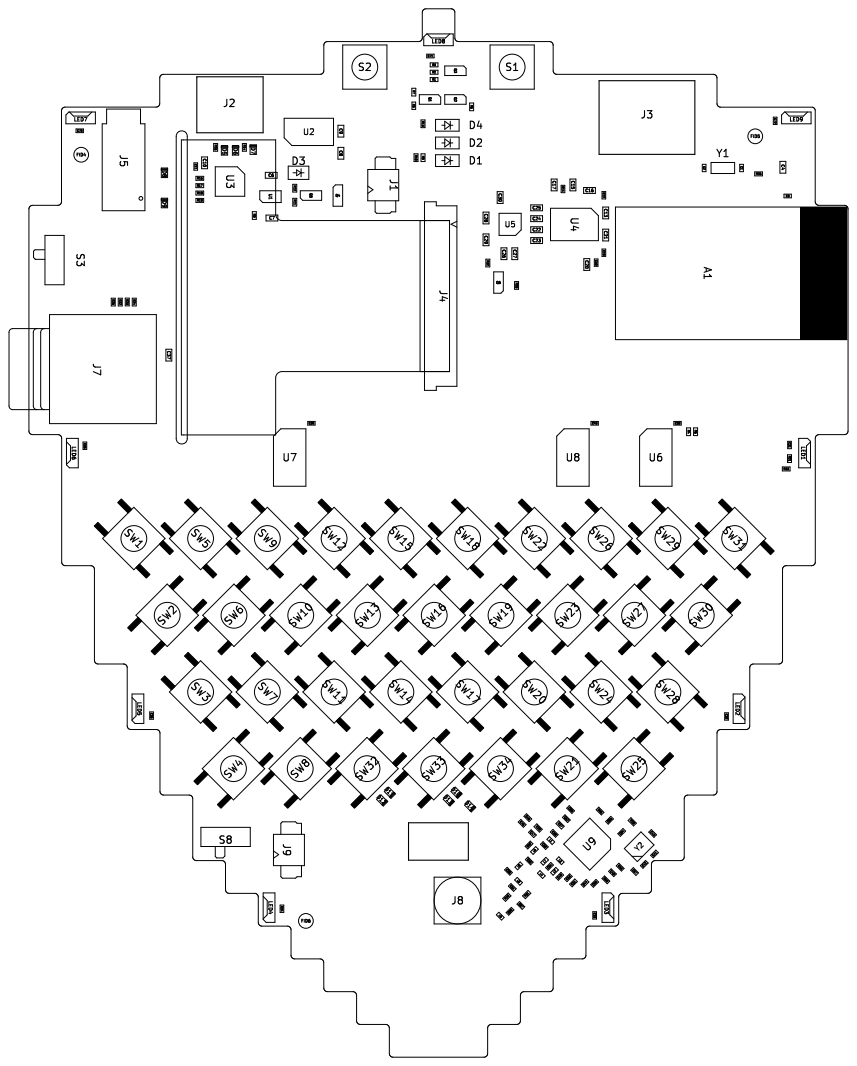
[picture p40: page 1]
