jeffmakes/tr23-badge-hw/r1/build/tr23-r1-assembly/tr23-badge-r1-top.pdf

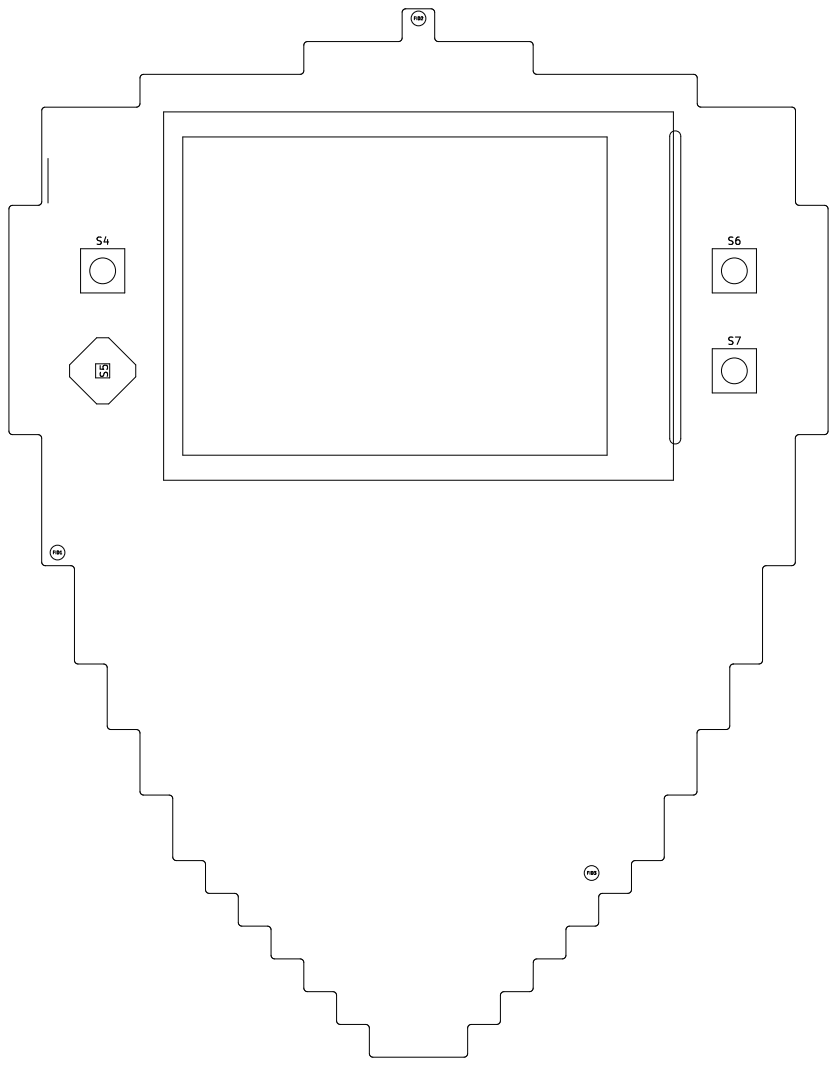
[picture p41: page 1]
