jeffmakes/tr23-badge-hw/docs/switch/6x6沉板贴片-Model.pdf

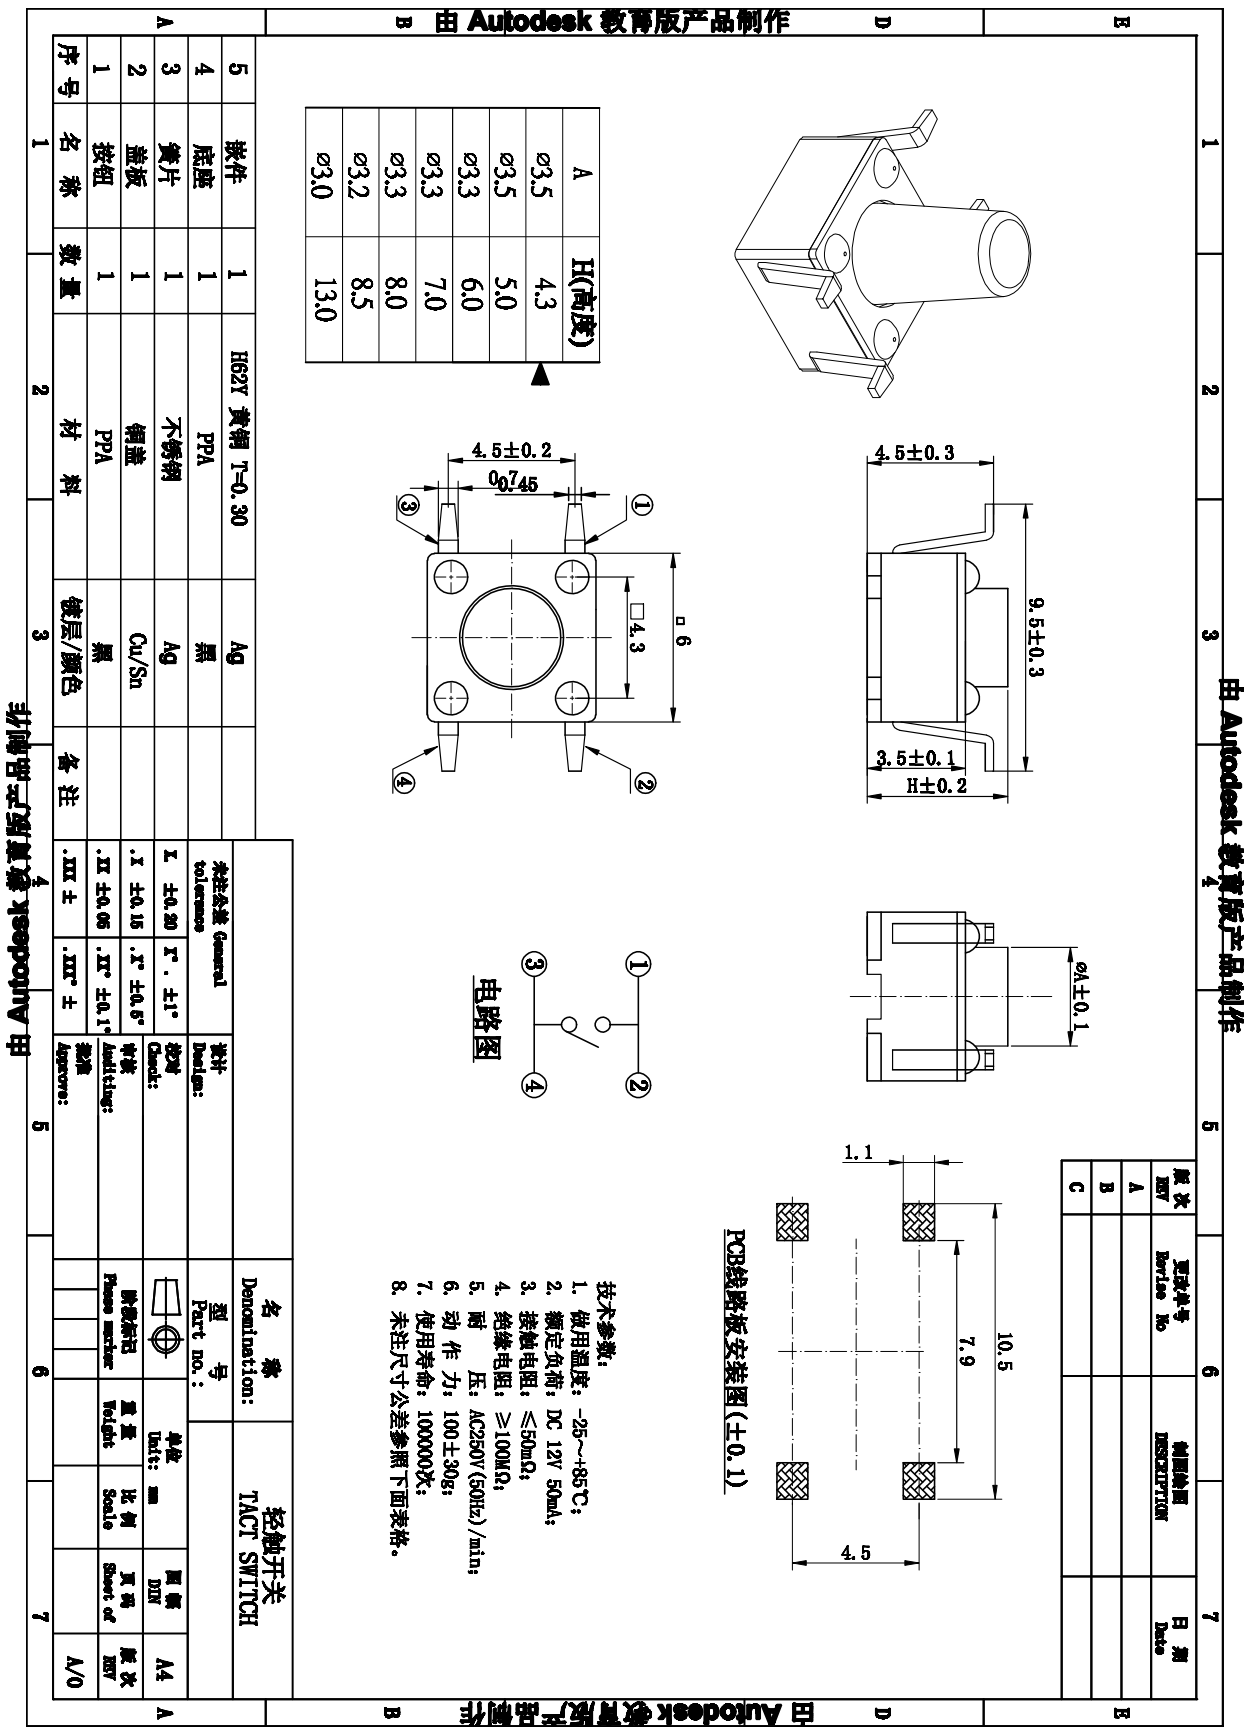
[picture p42: page 1]
