jeffmakes/tr23-badge-hw/(commit log)

2023-02-27 Initial commit. Add Kicad libraries as submodules
2023-02-27 Add schematics from TR20 r2. Fix symbol references. Migrate away from deprecated Digikey libs
    [_audio.kicad_sch, _display.kicad_sch, _haptic.kicad_sch, _io_expander.kicad_sch, _leds.kicad_sch, _micro_sd.kicad_sch, _power.kicad_sch, _radio.kicad_sch]
2023-02-27 Project files. PCB file
    [tr23-badge-r1.kicad_pcb]
2023-02-27 Design notes and TODO
    [signals.ods, test.ods]
2023-02-27 Fix deprecated Digikey symbols in the power module:wq
    [_power.kicad_sch]
2023-02-27 Fix LDO symbol
    [_power.kicad_sch]
2023-02-27 Correct LDO cap values
    [_power.kicad_sch]
2023-02-27 Update all symbols
    [_audio.kicad_sch, _display.kicad_sch, _io_expander.kicad_sch, _leds.kicad_sch, _power.kicad_sch, _usb.kicad_sch, tr23-badge-r1.kicad_sch]
2023-03-01 Keyboard module
    [__keyboard.kicad_sch]
2023-03-01 Rename keyboard module to remove extraneous _
    [_keyboard.kicad_sch]
2023-03-01 Autoplace labels
    [_audio.kicad_sch]
2023-03-01 Add backlight driver FET, finish display bus wiring
    [_display.kicad_sch]
2023-03-01 Remove unnecessary module-level labels
    [_io_expander.kicad_sch]
2023-03-01 File noise
    [_keyboard.kicad_sch]
2023-03-01 Fix ERC-violating pin direction on LDO
    [_power.kicad_sch]
2023-03-01 add TODO
    [_display.kicad_sch]
2023-03-01 Backlight connection
    [tr23-badge-r1.kicad_sch]
2023-03-03 Replace display symbol with FFC connector, otherwise we won't have separate BOM entries for the display and connector
    [_display.kicad_sch]
2023-03-03 Assign MPN's and LCSC part numbers
    [_audio.kicad_sch, _display.kicad_sch, _io_expander.kicad_sch, _keyboard.kicad_sch, _leds.kicad_sch, _micro_sd.kicad_sch, _power.kicad_sch, _radio.kicad_sch]
2023-03-03 Assign manufacturers
    [_audio.kicad_sch, _display.kicad_sch, _io_expander.kicad_sch, _keyboard.kicad_sch, _micro_sd.kicad_sch, _power.kicad_sch, _radio.kicad_sch, _usb.kicad_sch]
2023-03-03 Reverse mount switch datasheet
2023-03-03 Export BOM
    [tr23-badge-r1.csv]
2023-03-03 Remove BOM XML from versioning
2023-03-03 gitignore bom xml
2023-03-05 Reannotate component refs
    [_audio.kicad_sch, _display.kicad_sch, _io_expander.kicad_sch, _keyboard.kicad_sch, _leds.kicad_sch, _micro_sd.kicad_sch, _radio.kicad_sch, _shitty_addon.kicad_sch]
2023-03-05 Assign footprints from jeffmakes-footprints lib
    [_audio.kicad_sch, _display.kicad_sch, _io_expander.kicad_sch, _keyboard.kicad_sch, _micro_sd.kicad_sch, _power.kicad_sch, _shitty_addon.kicad_sch, _usb.kicad_sch]
2023-03-05 Assign footprints
    [_io_expander.kicad_sch, _keyboard.kicad_sch, _power.kicad_sch, _radio.kicad_sch, tr23-badge-r1.kicad_sch]
2023-03-09 Developing the board design for Kicad import via SVG2Shenzhen Inkscape plugin. Refinements to silkscreen. Board outline has various different corner radii to test tactile feel. Button locations defin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
2023-03-10 Create new project to test the shape of the board profile. How pointy are the corners? What's the minimum radius that will feel ok whilst not sacrificing too much pixelliness. These questions will be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
    [tr23-outline-test-r1.kicad_pcb, tr23-outline-test-r1.kicad_sch]
2023-03-10 Tweak positions of button holes. Add ERNW logo to silk
2023-03-10 Place switches, start routing
    [tr23-outline-test-r1.kicad_pcb]
2023-03-10 Remove inner corner radii from board outline
2023-03-10 Update SVG export
    [tr23-outline-test-r1.kicad_pcb, tr23-outline-test-r1.kicad_sch]
2023-03-10 Remove rear silkscreen text
    [tr23-outline-test-r1.kicad_pcb]
2023-03-10 Lock buttons
    [tr23-outline-test-r1.kicad_pcb]
2023-03-11 Fix imperfections in board outline from removing inner radii. Adjust silk navigation arrows, tweak positions of navigatation button text
2023-03-11 Add navigation switches and SAO connector to schematic.
    [tr23-outline-test-r1.kicad_sch]
2023-03-11 Initial BoM data as sent to Allnet to begin sourcing. Images included in spreadsheet to improve clarity.
    [tr23-badge-r1.xlsx]
2023-03-11 Tweak logo position
    [tr23-outline-test-r1.kicad_pcb]
2023-03-11 Route missing track for nav switch
    [tr23-outline-test-r1.kicad_pcb]
2023-03-11 BOM CSV update
    [tr23-badge-r1.csv]
2023-03-11 Add FFC connector for display.
    [tr23-outline-test-r1.kicad_pcb, tr23-outline-test-r1.kicad_sch]
2023-03-11 Fabrication data for tr23-outline-test-r1
    [tr23-outline-test-r1-B_Cu.gbr, tr23-outline-test-r1-B_Mask.gbr, tr23-outline-test-r1-Edge_Cuts.gbr, tr23-outline-test-r1-F_Cu.gbr, tr23-outline-test-r1-F_Mask.gbr, tr23-outline-test-r1-F_Silkscreen.gbr, tr23-outline-test-r1-NPTH.drl, tr23-outline-test-r1-PTH.drl]
2023-03-11 Add GND pour to top layer
    [tr23-outline-test-r1.kicad_pcb]
2023-03-11 Refill pours
    [tr23-outline-test-r1.kicad_pcb]
2023-03-11 Update Gerbers
    [tr23-outline-test-r1-B_Cu.gbr, tr23-outline-test-r1-B_Mask.gbr, tr23-outline-test-r1-Edge_Cuts.gbr, tr23-outline-test-r1-F_Cu.gbr, tr23-outline-test-r1-F_Mask.gbr, tr23-outline-test-r1-F_Silkscreen.gbr, tr23-outline-test-r1-job.gbrjob]
2023-03-13 Change 1-pixel point at bottom of profile to 3-pixels wide.
    [tr23-outline-test-r1.kicad_pcb]
2023-03-13 Profile test Gerber data
    [tr23-outline-test-r1-B_Cu.gbr, tr23-outline-test-r1-B_Mask.gbr, tr23-outline-test-r1-Edge_Cuts.gbr, tr23-outline-test-r1-F_Cu.gbr, tr23-outline-test-r1-F_Mask.gbr, tr23-outline-test-r1-F_Silkscreen.gbr, tr23-outline-test-r1-job.gbrjob]
2023-03-13 Update SVG export footprint
2023-03-23 Update display footprint
    [tr23-outline-test-r1.kicad_pcb]
2023-03-23 Footprint table
2023-03-23 ERC pass. Schematic complete.
    [_audio.kicad_sch, _display.kicad_sch, _io_expander.kicad_sch, _keyboard.kicad_sch, _micro_sd.kicad_sch, _power.kicad_sch, _radio.kicad_sch, _shitty_addon.kicad_sch]
2023-03-23 Import work from outline test PCB
    [tr23-badge-r1.kicad_pcb]
2023-03-24 Set outer corner radii to 0.5mm. The 0.5mm radii on the aesthetic test board are good - not too pointy, but still nice and pixelly
2023-03-24 Set inner corner radii to 0.5mm
2023-03-24 Update board graphics footprint
2023-03-24 Switch 5-way nav switch footprint.
    [_io_expander.kicad_sch]
2023-03-24 Set board stackup and design rules, assign netclasses
    [tr23-badge-r1.kicad_pcb]
2023-03-25 Correct position of the 'B' character in the silk
    [tr23-badge-r1.kicad_pcb]
2023-03-25 Tweaks to keyboard silk
    [tr23-badge-r1.kicad_pcb]
2023-03-25 Current limiting resistor for backlight
    [_display.kicad_sch]
2023-03-25 Change to side-firing LED's
    [_leds.kicad_sch]
2023-03-25 Assign more net classes. Set RF 50ohm width with coplanar ground-backed calculation
    [_radio.kicad_sch, _usb.kicad_sch, tr23-badge-r1.kicad_pcb, tr23-badge-r1.kicad_sch]
2023-03-25 Schematic for 9 LEDs
    [_leds.kicad_sch]
2023-03-25 Set netclass for USB diff pair
    [_usb.kicad_sch]
2023-03-25 Route USB bus with 90ohm differential impedance assuming stackup configured in Kicad
    [tr23-badge-r1.kicad_pcb]
2023-03-25 Side firing LED datasheet
2023-03-26 Route USB-UART and arrange power section
    [tr23-badge-r1.kicad_pcb]
2023-03-26 Remove duplicate connections from keyboard switches
    [_keyboard.kicad_sch, _usb.kicad_sch, tr23-badge-r1.kicad_pcb]
2023-03-27 Set keyboard net names
    [_keyboard.kicad_sch]
2023-03-27 First attempt at routing the keyboard
    [tr23-badge-r1.kicad_pcb]
2023-03-27 Keyboard routed
    [tr23-badge-r1.kicad_pcb]
2023-03-27 Change tact button footprint
    [_io_expander.kicad_sch, _power.kicad_sch, _usb.kicad_sch, tr23-badge-r1.kicad_sch]
2023-03-27 Rearrange power area to provide more clearance for text around rear buttons
    [tr23-badge-r1.kicad_pcb]
2023-03-28 Correct display connector position. Route SD bus
    [tr23-badge-r1.kicad_pcb]
2023-03-28 Position audio sectoin
    [tr23-badge-r1.kicad_pcb]
2023-03-28 Tweak position of nav and A buttons, and update silk to match
    [tr23-badge-r1.kicad_pcb]
2023-03-28 Fix some DRC violations, remove footprint silk text.
    [tr23-badge-r1.kicad_pcb]
2023-03-28 Display routed
    [tr23-badge-r1.kicad_pcb]
2023-03-28 Radio routed
    [tr23-badge-r1.kicad_pcb]
2023-03-28 Correct power switch footprint
    [_power.kicad_sch, _usb.kicad_sch, tr23-badge-r1.kicad_pcb]
2023-03-28 Speaker connector and mute switch
    [_audio.kicad_sch, _usb.kicad_sch, tr23-badge-r1.kicad_pcb]
2023-03-28 Mute switch and speaker routing
    [tr23-badge-r1.kicad_pcb]
2023-03-28 Route LED's
    [tr23-badge-r1.kicad_pcb]
2023-03-28 Route amp digital signals. Fix tracks with non-netclass width
    [tr23-badge-r1.kicad_pcb]
2023-03-28 Long range routing complete
    [tr23-badge-r1.kicad_pcb]
2023-03-29 Change severity of a couple of DRC rule alerts
2023-03-29 Custom DRC rule for through-board bottom-entry female pin header
2023-03-29 Exclude silk artwork footprint from BoM and placement data
2023-03-29 DRC pass
    [tr23-badge-r1.kicad_pcb]
2023-03-29 Add some test pads to the power rails
    [_power.kicad_sch]
2023-03-29 Add rear silk text; version, credits, etc. DRC pass.
    [tr23-badge-r1.kicad_pcb]
2023-03-29 Add some test pads to the display bus
    [_display.kicad_sch]
2023-03-29 Add display bus test pads. Set board colours for 3D view
    [tr23-badge-r1.kicad_pcb]
2023-03-29 Remove weird path segment from board edge
2023-03-29 Move as many vias as possible out of the front silk, to improve aesthetics
    [tr23-badge-r1.kicad_pcb]
2023-03-29 Exclude test pads, graphics, etc., from BOM
    [_display.kicad_sch, _power.kicad_sch, _radio.kicad_sch, tr23-badge-r1.csv, tr23-badge-r1.kicad_pcb, tr23-badge-r1.kicad_sch, tr23-badge-r1.xlsx]
2023-03-29 BoM updated, including XSLX (in previous commit)
    [tr23-badge-r1.csv]
2023-03-29 Tweak a track
    [tr23-badge-r1-B_Cu.gbr, tr23-badge-r1-B_Mask.gbr, tr23-badge-r1-B_Paste.gbr, tr23-badge-r1-B_Silkscreen.gbr, tr23-badge-r1-Edge_Cuts.gbr, tr23-badge-r1-F_Cu.gbr, tr23-badge-r1-F_Mask.gbr, tr23-badge-r1-F_Paste.gbr]
2023-03-29 Change reverse-mount switch symbols to include manufacturer and value
    [_keyboard.kicad_sch, tr23-badge-r1.kicad_pcb]
2023-03-29 Update BoM to include reverse-mount switch data
    [tr23-badge-r1.csv, tr23-badge-r1.xlsx]
2023-03-29 Assembly data
2023-03-29 Interactive BOM generator settings
2023-03-29 Interactive BoM
2023-04-19 Tidy up F.Fab and B.Fab layers so each component has its refdes correctly placed. This is a requirement of Chinese assembly houses - they require a PDF of all component placements in addition to the 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
    [tr23-badge-r1.kicad_pcb]
2023-05-15 Fix USB-C connector BoM data
    [_usb.kicad_sch, tr23-badge-r1.xlsx]
2023-05-15 Create project tree for r2
    [_audio.kicad_sch, _display.kicad_sch, _io_expander.kicad_sch, _keyboard.kicad_sch, _leds.kicad_sch, _micro_sd.kicad_sch, _power.kicad_sch, _radio.kicad_sch]
2023-05-16 Update BoM. Fix ESP32 module MPN, add clarification requests for Allnet
    [tr23-badge-r2.xlsx]
2023-05-16 Fix tactile switch symbols. By using a two-pin symbol rather than the truer 4-pin one, signals were shorted at the footprint
    [_io_expander.kicad_sch, tr23-badge-r2.kicad_sch]
2023-05-16 Switch around some signals on the ESP32 so: 1) BACKLIGHT is not on an input-only pin 2) The IO0 bootloader line is shared with the radio CS line rather than the display reset line, so display doesn't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
    Also, updating Kicad bumps some version signifier in the files, so there
    is some file noise.
    [_audio.kicad_sch, _display.kicad_sch, _io_expander.kicad_sch, _keyboard.kicad_sch, _leds.kicad_sch, _micro_sd.kicad_sch, _power.kicad_sch, _radio.kicad_sch]
2023-05-17 Correct switch symbol so default switch behaviour from factory is correctly shown.
    [_audio.kicad_sch, _power.kicad_sch]
2023-05-17 Correct wiring of Mute switch so it default to unmuted from the factory
    [tr23-badge-r2.kicad_pcb]
2023-05-17 Fix off-grid ERC errors so whole schematic is on 1.27mm grid
    [_display.kicad_sch, _keyboard.kicad_sch, _leds.kicad_sch, _radio.kicad_sch, tr23-badge-r2.kicad_sch]
2023-05-17 USB-C connector datasheet
2023-05-17 Reverse-mount switch datasheet
2023-05-17 Suppress ERC warnings from 'library symbol issues', whatever they are, because a bug in Kicad triggers this warning due to multiple pin with the same number existing in a symbol. This is necessary in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
2023-05-17 Update WROVER with renamed footprint
    [tr23-badge-r2.kicad_sch]
2023-05-17 Center layout inside the drawing sheet frame. Set design origin to drill file and placement origin. Position origin in the same place as in r1 - center of bottom edge of PCB
2023-05-17 Update USB-C connector to fix DRC weirdness
    [_usb.kicad_sch]
2023-05-18 Compact radio layout to make space for speaker and its connector
2023-05-18 Change speaker connector symbol to include mounting pads. Add speaker symbol and footprint
    [_audio.kicad_sch]
2023-05-18 Change battery connector symbol to include mounting pads.
    [_power.kicad_sch]
2023-05-18 Update WROVER with symbol including NC pins.
    [tr23-badge-r2.kicad_sch]
2023-05-19 Add pull-downs to amplifier enable/gain control lines
    [_audio.kicad_sch]
2023-05-19 Increase resistance of charging LED resistor - it was extremely bright
    [_power.kicad_sch]
2023-05-19 Place speaker and its connector
2023-05-19 Rename speaker footprint
    [_audio.kicad_sch]
2023-05-19 R1 schematic PDF plot
2023-05-20 Export rear silk graphic footprint, import to board
2023-05-20 Footprint reference for BSilk graphic
    [tr23-badge-r2.kicad_sch]
2023-05-20 Move LED caps out of silk area. Rotate speaker because its holes were in the front silk.
2023-05-20 Rebuild footprint and symbol tables to include latest commits to the official repositories. This was part of an attempt to get rid of some DRC warnings about footprints in the PCB being different fro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
    [tr23-badge-r2.kicad_sch]
2023-05-20 Add BOM info for side-firing SK LED's
    [_leds.kicad_sch]
2023-05-20 Submodule updates to incorporate latest commits pulled from Kicad official libs
2023-05-20 Net class width for audio traces
2023-05-20 Custom design rule for SAO connector
2023-05-20 Fix additional pour keepout for antenna. Set fabrication export settings
2023-05-20 Modify drawing of speaker wires to better represent 10mm length with some slack
2023-05-21 Set title block contents
    [_audio.kicad_sch, _display.kicad_sch, _io_expander.kicad_sch, _keyboard.kicad_sch, _leds.kicad_sch, _micro_sd.kicad_sch, _power.kicad_sch, _radio.kicad_sch]
2023-05-21 Set schematic plot output dir
2023-05-21 Placement data and human-readable PDF plots
    [tr23-badge-r2-bottom-pos.csv, tr23-badge-r2-top-pos.csv]
2023-05-21 Custom DRC rule to catch accidental vias-in-pads, with exclusions for the footprints that need them
2023-05-21 Regenerate assembly data after nudging FFC connector
    [tr23-badge-r2-bottom-pos.csv]
2023-05-21 Gerber job file
    [tr23-badge-r2-job.gbrjob]
2023-05-21 Schematic plot export
2023-05-21 Increase via-in-pad DRC distance
    [tr23-badge-r2-B_Cu.gbr, tr23-badge-r2-B_Fab.gbr, tr23-badge-r2-B_Mask.gbr, tr23-badge-r2-B_Paste.gbr, tr23-badge-r2-B_Silkscreen.gbr, tr23-badge-r2-Edge_Cuts.gbr, tr23-badge-r2-F_Cu.gbr, tr23-badge-r2-F_Fab.gbr]
2023-05-21 Production notes. Add 1.2mm board thickness instruction
2023-05-21 BoM update
    [tr23-badge-r2.csv]
2023-05-21 Change speaker part number to -35 variant, I think the -40 may have been discontinued, and I doubt it makes much odds
    [_audio.kicad_sch]
2023-05-21 Add speaker images to BoM
